MrDaila007/velopulse/STATUS.md

# Статус проекта

Обновлено: 2026-08-20

## Снимок веток

| Ветка | Состояние | Комментарий |
| --- | --- | --- |
| `dev` | **Активная разработка** | BLE Э4, Flutter MVP, ПК веб-компаньон, ambient auto-calibration |
| `main` | Устарела | Отстаёт от `dev`; актуальный код только на `dev` |
| `feat/speed-gap-reboot-load-config` | Влита в `dev` (`4dd8437`) | Исходная ветка на 3 коммита впереди своей копии в `dev` |
| `cursor/weather-carousel-5d1a` | Влита в `dev` | Weather-страницы карусели |
| `cursor/peripheral-features-research-c36d` | Не влита | Research/backlog доки по периферии, вне текущей области |
| `cursor/update-project-status-9eb0` | Не влита, устарела | Черновой docs-sync от 2026-08-08; заменён этим обновлением |

Версии продукта — [`version.toml`](version.toml): BLE protocol `1.2`, firmware
Arduino `0.2.0`, firmware Zephyr `0.2.0-zephyr`, mobile `1.1.0+6`. Публичные релизы:
`v0.2.0-beta.1/2/3`.

## Текущий этап

Э4 — BLE-интеграция. Э4.1–4.15 программно реализованы: advertising, команды,
encryption, pairing window и BLE CSC central (C3 каденс / S3 скорость, ADR-014).
Базовая интеграция Android-приложения с реальным XIAO подтверждена пользователем.
Полный hardware gate Э5 и полевая проверка Cycplus C3/S3 ещё открыты.

## Готово

### Прошивка (Arduino, PlatformIO)

- PlatformIO-проект для XIAO nRF52840 Sense и native-окружения.
- Фильтрация импульсов, fixed-point скорость, дистанция, средняя/максимальная скорость.
- Автостарт и автопауза, неблокирующий scheduler, ISR с кольцевым буфером.
- `SpeedIntervalGuard`: отбрасывает и считает аномально короткие интервалы между
  импульсами (дребезг/наводка) до расчёта скорости, не давая ложным всплескам
  попасть в `SpeedCalculator`.
- Минимальный OLED-интерфейс, проверенный на устройстве с кнопкой вместо датчика Холла.
- GUI/headless-симулятор OLED и pixel-golden тесты состояний IDLE/MOV/PAUSE.
- `PageCarousel` с настройкой порядка, маски, периода и фиксированной страницы.
  Расширена до 7 страниц: добавлены `kWeatherClock`/`kWeatherRain` (BLE Companion
  Sync), `kValidEnabledPagesMask = 0x7F`; новые страницы opt-in
  (`kDefaultEnabledPagesMask` не изменена), появляются через второй проход
  `configure()`, не занимая слоты `page_order`.
- Общий C++-форматтер пяти нижних страниц, погодных страниц и индикатора батареи.
- Общая C++-разметка: прошивка и симулятор исполняют один и тот же код отрисовки.
- Pixel-golden кадры всех страниц, IDLE/PAUSE, неизвестного и низкого заряда.
- Два compile-time OLED-профиля из общего renderer: primary SSD1306 128×64 с
  Logisoso 38 и совместимый 128×32 с неизменными пикселями; BLE/config не менялись.
- `BatteryModel`: пересчёт ADC, калибровка, EMA, SoC LUT, монотонность и гистерезис.
- `BatteryManager`: 16 ADC-выборок и min/max rejection для внешнего делителя на P0.31.
- Аппаратная документация приведена к фактической схеме NologoTech Super-nRF52840.
- Внешний делитель 1 MΩ / 1 MΩ на P0.31 распаян и проверен: 4.016–4.037 В, 84–86% при зарядке.
- Автономная работа от Li-Po без USB и сохранение индикации заряда подтверждены пользователем.
- Установившийся разброс 16 выборок: 16–25 ADC counts (примерно 19–29 мВ).
- `DisplayPower`: приглушение на половине тайм-аута, выключение и пробуждение.
- `DisplayManager`: управление контрастом и SSD1306 power-save; корректный импульс
  колеса немедленно возвращает экран в яркий режим.
- `DisplayBurnInGuard`: независимо от auto-off раз в 60 с циклически смещает общий
  renderer на один пиксель по четырём позициям; работает для 128×64 и 128×32,
  wrap-safe и не изменяет splash/test patterns.
- `AmbientLightModel`: EMA 1/8, raw normalization, уровни 5/15/35/65/100%,
  гистерезис 5%, выдержка 2 с и invalid fallback. `AmbientLightManager` раз в
  секунду коммутирует D3, на следующем tick усредняет 16 ADC-выборок с min/max
  rejection; `brightness_pct` остаётся пользовательским максимумом.
- **Ambient light auto-calibration** (влито в `dev`, коммит `7b1d52d`):
  `AmbientLightCalibrator` подстраивает raw dark/bright границы по наблюдаемым
  выборкам во время работы, с оценкой качества (`kNarrow`/`kOk`) по ширине диапазона
  и допустимым dark/bright порогам; `AmbientCalibrationSavePolicy` — независимый от
  `OdometerSavePolicy` набор триггеров: time-throttled изменения плюс
  one-shot deep sleep/reboot/USB disconnect. Хранится в новых A/B-слотах
  `/alc_a`/`/alc_b` (`StoragePaths`), record version 1, payload 5 байт. При старте
  калибровка загружается и используется как seed вместо статических
  `BIKECOMP_AMBIENT_RAW_DARK/BRIGHT`; переживает deep sleep, reboot и USB disconnect.
- Канонический little-endian codec 48-байтовой `DeviceConfig` без зависимости от
  C++ padding; валидируются все диапазоны, маска/порядок страниц и имя устройства.
- `StorageManager`: `/cfg_a/b`, `/odo_a/b`, `/alc_a/b` и `/cnt_a/b`, заголовок `BKCP`,
  version, sequence, CRC32, выбор свежего слота, чередование записей и пропуск
  неизменённых данных.
- При повреждении одного слота используется второй; при повреждении обоих defaults
  записываются в слот A (кроме `StorageCounters` — см. ниже). Одометр, общее число
  оборотов, ambient-калибровка и `StorageCounters` восстанавливаются при старте.
  Для `StorageCounters` это правило про defaults не действует: если оба
  `/cnt_a`/`/cnt_b` отсутствуют или повреждены, `loadStorageCounters()` не пишет
  ничего в Flash — `counters_` просто остаётся в нулевом RAM-состоянии до
  следующего `saveStorageCounters()` на контрольной точке.
- Serial при старте показывает mount status, source, sequence, version, recovery/
  defaults, migration и восстановленное значение одометра.
- `OdometerSavePolicy`: независимые триггеры дистанции (`odometer_save_interval_m`),
  settle 30 с после `MOVING→PAUSED`, OLED off, deep sleep, `FORCE_SAVE`, critical
  battery ≤5% (однократно), USB disconnect и reboot; ошибка Flash не останавливает
  поездку. `AppController` пишет одометр и логирует trigger/result/sequence/counters.
- **Device reboot**: команда `reboot` в Serial-консоли и BLE `CommandId::kReboot` —
  сначала пытаются сохранить одометр (`OdometerSaveTrigger::kReboot`), затем ставят
  отложенный флаг и выполняют системный reset через 250 мс
  (`AppController::loop`, `reboot_pending_`/`reboot_requested_ms_`).
- `storage_migration`: `migrateConfigV1ToV2` / `migrateOdometerV1ToV2` (identity stub
  при неизменном payload); `RecordHeader.version` = 2. При load запись v1
  мигрируется, перезаписывается как v2 (force write); будущая version отвергается.
  Счётчики `config_migrations` / `odometer_migrations`.
- `diagnostics`: snapshot §6.1 (`raw_pulse_count`, debounce/overspeed rejects,
  `isr_overflow`, `flash_write_count` ← `StorageCounters::writes`,
  `free_heap` через `dbgHeapFree()`, i2c/selftest). Little-endian 16-byte payload
  возвращается через `GET_DIAGNOSTIC`. Serial dump при старте;
  `AppController::diagnosticSnapshot()`. `StorageCounters` персистируются в
  `/cnt_a|b` на контрольных точках, не на каждой записи (см. «Ограничения»).
- **Watchdog (Э2.1-долг закрыт)**: nRF52 WDT через `src/platform/watchdog_nrf52.cpp`
  (`nrf_wdt.h` HAL напрямую — `nrfx_wdt` driver source не собран в этом core,
  `nrfx_wdt_*` не слинковался бы). `watchdogConfigure()` вызывается первой строкой
  `begin()` (CONFIG/RREN/CRV блокируются после старта), `watchdogStart()` —
  последним шагом `begin()`, после Serial-ожидания, монтирования FS, boot-counter
  и SoftDevice init. `watchdogFeed()` безусловно первой строкой `loop()` и перед
  входом в deep sleep. Таймаут 8 с (`BIKECOMP_WDT_TIMEOUT_MS`,
  `watchdog_config.h::watchdogTimeoutMsToCrv`), RUN_SLEEP behaviour (считает во
  сне, пауза под отладчиком). Выключается сборочным флагом
  `BIKECOMP_FEATURE_WATCHDOG=0`. `kSelftestWatchdogOk` выставляется при успешном
  старте. Serial-команда `wdt-hang` вешает `loop()` для проверки реального сброса.
  Попутно исправлен смежный баг: `deepSleepWakeFromSleep()` перечитывал уже
  очищенный `NRF_POWER->RESETREAS` и никогда не репортил `wake_source=hall/usb` —
  теперь кэшированное значение передаётся параметром.
- **Scheduler task timing (Э2.1)**: `ScheduledTask` хранит `last_duration_us`/
  `max_duration_us`/`overrun_count` против per-task `budget_us`, замеряется через
  инжектируемый `Scheduler::MicrosFn` (домен остаётся Arduino-независимым).
  `AppController` подключает `micros()` и именованные бюджеты с headroom под
  flash-запись (state/ambient/display/battery — один write, ble — до трёх при
  factory reset). Serial-команда `sched`. Попутно исправлен смежный баг:
  `Scheduler::nextDueMs` сравнивал сырые `next_due_ms` вместо wrap-safe дельты и
  мог занизить срочность задачи почти на 2^31 мс вокруг переполнения `millis()`.
- **Async flash writes**: `StorageBackend::beginWrite`/`pollWrite`
  (`storage_manager.h`) заменили синхронный `write()`; `InternalFsBackend`
  (`internal_fs_backend.{h,cpp}`) разбивает remove+open+write+flush+close на
  два `pollWrite()`-тика. Новая scheduler-задача `"storage"`
  (`AppController::pollStorageSave`) двигает mid-ride сохранения одометра/
  ambient-калибровки/counters; старые синхронные `saveConfig`/`saveOdometer`/
  `saveAmbientCalibration`/`saveStorageCounters` остались тонкими
  begin+drain обёртками для boot-time и non-hot-path вызовов. Deep sleep и
  оба `reboot`-чекпоинта синхронно дренируют (`drainStorageSave()`) любую
  незавершённую запись перед power-off/reset.
- BLE Э4.1–4.14: `BleManager` GATT + live Device Info на Read (uptime, flags,
  bonded, pairing window); FICR serial; `reset_reason` из `NRF_POWER->RESETREAS`;
  `boot_count` в `/boot_cnt`; live Telemetry notify (seq + adaptive 1 Гц /
  0.2 Гц Read refresh; sensor-test 5 Гц); Config Write pending queue +
  validation/apply + Config Read notify. Safe Command `0x01–0x0B`: strict parser,
  single-slot queue и выполнение в main loop (`RESET_TRIP/MAX`, `FORCE_SAVE`, OLED,
  display/sensor/battery tests, diagnostics, reboot); корректные `Command Result`
  status, `detail` и 16-byte payload; sensor-test завершается по timeout/disconnect.
  ADV Flags + Service UUID, Scan Response name + Tx Power; fast 30 мс первые 30 с,
  slow 1000 мс, постоянная реклама по умолчанию либо stop через 5 минут; рестарт
  после disconnect/движения, runtime-применение имени и policy. Имя `BikeComp-XXXX` →
  serial (`ble_identity`); ack одометра только при успехе Flash; hot-path Serial
  за `BIKECOMP_HOTPATH_SERIAL` (по умолчанию выкл).
  Dangerous Command `0x20–0x40`: двухфазный request/confirm, аппаратный 32-bit
  nonce, TTL 30 с, binding к command/payload/connection, обязательный bonded link,
  single-slot execution и token/error statuses. Реализованы reset odometer/factory,
  reboot с отложенным reset, battery calibration, set odometer и runtime pairing
  window; параметры сохраняются до ответа OK.
  Adafruit BLEDfu в том же `BleManager`: buttonless переход в bootloader OTA
  (`GPREGRET=0xB1`) при записи DFU Control Point; первая заливка при мёртвом USB —
  `firmware/scripts/flash_stlink.sh`, дальше `firmware.zip` с телефона. Это не
  Nordic Secure DFU v1.1.
- **BLE CSC central (Э4.15, ADR-014):** dual-role `Bluefruit.begin(1, 1)`. BikeComp
  остаётся peripheral для приложения и одновременно central к одному датчику
  CSC `0x1816`. CYCPLUS C3 даёт каденс (`cadence_x10`, OLED CAD); CYCPLUS S3 даёт
  скорость/одометр через синтетические обороты и `wheel_circumference_mm`. Пока
  S3 свежий (менее 4 с), импульсы Холла не считаются. Bond в `/csc_a` `/csc_b`,
  Serial `csc-pair`/`csc-forget`/`csc-status`. ANT+ не используется (S140).
  Telemetry v2 — 44 байта, протокол 1.2. Zephyr CSC central — заглушка.
  Pairing/bonding: LESC Just Works, Flash bond store Bluefruit, encrypted GATT
  permissions, release-default `BIKECOMP_OPEN_PAIRING=0`; новые pairing requests
  после 5 минут отклоняются disconnect + defensive bond revoke, сохранённые bonds
  допускаются. Dangerous commands требуют одновременно bonded и encrypted link.
  Android preflight показывает typed `notPaired` по Device Info без reconnect-loop.
  Error Log: RAM-кольцо 16 событий, Read/Notify последних 4 в хронологическом порядке;
  регистрируются I²C/Flash/config reject/pairing reject/ISR overflow/sensor stuck/
  watchdog/critical battery. Sensor-test использует нормативные Telemetry fields и
  принудительный интервал 200 мс; timeout, stop и disconnect завершают режим.
  BLE Companion Sync: время и погода на OLED (protocol 1.1, характеристика `000B`) —
  питает страницы `kWeatherClock`/`kWeatherRain`.
- Неблокирующая USB Serial-консоль: `open-pairing`, `dump-config`, `reset-odo`,
  `reboot`, `selftest`; CR/LF, ограничение длины и восстановление после переполнения
  проверены native-тестами. `dump-config` возвращает читаемые поля и точный 48-byte
  wire payload. Регрессионный протокол и host-runner: `tools/usb_regression.py`.
- **BLE-индикатор на OLED (Э2.7 закрыт)**: `DisplaySnapshot`/`DisplayFrame`
  (`include/types.h`) содержат `ble_connected`; общий `display_layout.cpp` рисует
  `"BLE"` при подключении (pixel-golden покрытие в `simulator/`); AppController
  подключает живое значение — `snapshot.ble_connected = ble_.bleConnected();`
  в `AppController::updateDisplay()` (`src/app_controller.cpp`).

### Мобильное приложение (Flutter)

- `mobile-app`: Flutter 3.44.7, application ID `app.bikecomp.mobile`, minSdk 24,
  compileSdk/targetSdk 36; четыре Material 3 раздела и connecting overlay-route.
  Реализованы protocol v1 Freezed-модели/codecs, полный ConfigValidator,
  `FakeBleTransport`, production `flutter_reactive_ble` transport, Android
  permissions/adapter/location/bond layer, FSM/reconnect, domain repository,
  write-then-verify и versioned per-device dirty drafts. Устранена lifecycle race,
  где `unawaited(stopScan())` закрывал только что созданный scan stream. Discovery
  выполняет нефильтрованный platform scan с локальной проверкой service UUID и
  fallback по имени `BikeComp-*`; после connect полный GATT-контракт обязателен.
  Device Info читается до protected GATT operations; encrypted Config Read завершает
  pairing до subscriptions. Ошибки sync и cancel освобождают единственный BLE link.
  Settings показывает «Максимальная яркость» с пояснением автоматики; Maintenance
  отправляет fill/checkerboard/text через существующую команду `DISPLAY_TEST`,
  без изменения BLE wire format.
  Dashboard, MVP settings, defaults и maintenance не включают diagnostics/export/
  dangerous commands Э6.
  Воспроизводимый Flutter/JDK/Android SDK/NDK/CMake toolchain лежит в игнорируемой
  `.tooling/` и разворачивается `tool/bootstrap-mobile.sh`.

### ПК веб-компаньон

- `web-app/` (см. [`docs/10-web-app.md`](docs/10-web-app.md)): локальное веб-приложение
  для Chrome/Edge на ПК. Повторяет BLE-функции Flutter-компаньона (Web Bluetooth) и
  добавляет USB CDC Serial-консоль для отладки (Web Serial) — не поддерживается в
  Safari/Firefox/на мобильных браузерах, требует secure context (`https://` или
  `http://localhost`).

## Проверки

- `pio test -e native`: **128/128** тестов проходят (прогнано 2026-08-10), включая
  ambient auto-calibration, автояркость, weather-страницы, Serial ambient/display
  commands, advertising, safe/dangerous framing, shared fixtures, Config Write,
  diagnostics, Serial parser, watchdog CRV, Scheduler timing/wrap и
  wake-source classification.
- `pio run -e xiao_ble_sense`: primary 128×64 собирается, RAM 17 968 Б,
  Flash 191 492 Б (прогнано 2026-08-10, после watchdog+scheduler timing;
  +96 Б RAM — 4 новых `uint32_t` на 6 задач `ScheduledTask`).
- `pio run -e xiao_ble_sense_128x32`: compatible build собирается, RAM 17 456 Б,
  Flash 191 428 Б (прогнано 2026-08-10).
- `pio run -e xiao_ble_sense_deep_sleep`: собирается, RAM 17 968 Б,
  Flash 191 876 Б (прогнано 2026-08-10).
- Сборка с `-DBIKECOMP_FEATURE_WATCHDOG=0`: собирается, WDT не стартует
  (`kSelftestWatchdogOk` не выставляется) — прогнано 2026-08-10.
- `./simulator/test.sh`: 6 групп проверок, **24 golden-кадра** (12 сценариев ×
  128×32/128×64, включая `weather_clock`/`weather_rain`) — подтверждено 2026-08-10.
- Boot smoke на XIAO (`/dev/ttyACM0`): `BLE GATT: OK`, `BLE ADV name: BikeComp-D210`
  (не литерал `XXXX`), `OLED OK`, `selftest=0x3F`, `heap/16≈12695`, устройство
  стабильно после SoftDevice init.
- Embedded A/B-тест прошёл на XIAO: mount, A/B-чередование, чтение и fallback после
  повреждения свежего слота; `/test_storage_a/b` удалены после теста.
- Embedded odometer A/B на `/test_odo_a/b`: чередование и fallback после повреждения
  свежего слота; тестовые файлы удалены после теста (`pio test -e xiao_ble_sense`).
- DoD Э3.5 reboot на `/dev/ttyACM0`: seed 424242 mm / 77 rev переживает два reboot
  production (`Odometer: source=A, sequence=3`, те же значения оба раза).
- Mobile automatic gate: `dart format`, `flutter analyze` — no issues;
  `flutter test` — 52/52; актуальный release APK собран.
- Release APK: application ID `app.bikecomp.mobile`, minSdk 24, target/compileSdk 36,
  54,049,637 байт (`a31959c20eeb972c60070b30567f6f12bf94fc12a58051a64bc3203e7944f1c2`).
- Android-устройства через ADB и Bluetooth controller на хосте нет;
  локальные результаты не являются аппаратной приёмкой BLE.
- Primary production-сборка SSD1306 128×64 загружена на XIAO. Serial smoke:
  `i2c_err=0`, `isr_ovf=0`, `selftest=0x3F`, `heap/16=12630`. Пользователь подтвердил
  крупную разметку и работу экрана. Ранее проверенный профиль 128×32 остаётся
  совместимой сборкой; `reset-odo` на пользовательских данных не выполнялся.
- Ранее: два старта подряд прочитали config/odometer из слота A с `sequence=1`,
  без роста sequence и лишней записи.
- Пользовательский лог nRF Connect от 2026-07-31 подтверждает обнаружение
  `BikeComp-D210`, connect, service discovery, bonding и чтение Device Info,
  Telemetry, Config Read, Command Result и пустого Error Log. Ошибки
  `GATT READ NOT PERMIT` относятся к попыткам чтения descriptor у write-only chars;
  Config Write, команды и bond persistence этим логом не проверялись. Лог
  заканчивается без disconnect: пока nRF Connect держит единственное peripheral
  connection, firmware штатно не рекламируется и другое приложение его не найдёт.
- Android hardware smoke от 2026-07-31: после освобождения BLE-соединения в
  nRF Connect пользователь подтвердил, что новый release APK обнаруживает устройство,
  подключается и работает. Это закрывает базовую end-to-end интеграцию, но не заменяет
  измерение поиска ≤5 с, серию 10/10 и остальные пункты аппаратного gate.
- Прошивка загружалась на XIAO; OLED и импульсы кнопки подтверждены пользователем.
- Сборка `424fbc7` с общей C++-разметкой загружена на XIAO через `/dev/ttyACM0`.
- Сборка `4335e65` с энергосбережением OLED загружена через `/dev/ttyACM0`.
- На устройстве подтверждены приглушение через 30 секунд, выключение через 60 секунд
  и немедленное пробуждение по импульсу кнопки D0.
- На реальном OLED 128×32 подтверждены постоянная скорость, батарея справа сверху и
  автоматическая смена пяти нижних значений.
- Hardware smoke SSD1306 128×64 от 2026-07-31: primary firmware загружена на XIAO;
  Serial вернул `i2c_err=0`, `isr_ovf=0`, `selftest=0x3F`, `heap/16=12630`;
  крупная разметка и работа экрана подтверждены пользователем.
- Production 128×64 с автояркостью загружена через `/dev/ttyACM1` 2026-08-01.
  Без подключённого LDR три последовательных selftest дали `raw=0`, `valid=0`,
  `auto_pct=100`, `effective_pct=40`, `i2c_err=0`, `isr_ovf=0`,
  `selftest=0x3F`: аппаратный disconnected-sensor fallback подтверждён.
- Serial gate tools 2026-08-01: `pio test -e native` (83/83 на тот момент);
  `tools/oled_gate_serial.py` на XIAO подтвердил dim (30 с), off (60 с), wake;
  `tools/ldr_calibrate.py` — LDR не обнаружен; `tools/android_gate.sh` —
  format/analyze/52 tests/release APK.

## Ограничения

- Реальный датчик Холла и повторяемый стенд импульсов ещё не проверены.
- SSD1306 128×64 подключён и прошёл базовый hardware smoke; ещё не зафиксированы
  `LOW BATT`, test patterns, полный dim/off цикл и четыре фазы burn-in pixel shift.
- LDR-делитель ещё не собран: raw dark/room/outdoor, итоговый резистор,
  плавность переходов, максимумы 10/60/100% и средний ток ≤20 мкА ждут
  аппаратной проверки. Auto-calibration подстраивает пороги в рантайме и переживает
  reboot, но не заменяет физическую сборку делителя и замер тока.
- Штатные NPR-позиции делителя не используются; внешний делитель P0.31 подтверждён.
- Автосохранение одометра: native + на XIAO подтверждены odo A/B embedded и
  ненулевой odometer после двух reboot. Остаётся ручная проверка 10× power-loss
  (чтобы не уничтожить обе копии `/odo_a|b`). Тот же долг применим к новым
  `/alc_a|b` и `/cnt_a|b` — power-loss там ещё не проверялся.
- BLE: pairing enforcement и persistence собраны, но reboot/closed-window сценарии
  ещё не приняты на телефоне; лимит 4 bonds с LRU пока не реализован. Prototype
  override `BIKECOMP_OPEN_PAIRING=1` остаётся opt-in. Error Log Read/Notify и sensor
  test 5 Гц ждут BLE hardware DoD. Стандартные DIS/BAS (`0x180A`/`0x180F`) отложены;
  приложение их не использует. `flash_write_count` и остальные `StorageCounters`
  персистируются в `/cnt_a|b` только в контрольных точках — deep sleep и reboot
  (Serial `reboot`, BLE `CommandId::kReboot`) через
  `AppController::persistStorageCounters()`, не на каждой записи; значение после
  power-loss без чистого reboot отражает последний checkpoint, а не точный момент
  потери питания. Так как `StorageCounters::writes` теперь накапливается через
  весь срок службы устройства (а не сбрасывается каждую загрузку), поле
  `flash_write_count` в `GET_DIAGNOSTIC` — насыщающийся u16 (`saturateU16` в
  `diagnostics.cpp`, туда же попадает и `selftest`-снимок на Serial) — со
  временем реально достигает потолка 65535; это осознанное и уже протестированное
  поведение, не баг. Сам `StorageCounters::writes` при этом остаётся полным u32
  без потолка и виден без ограничения на Serial в строке `Odo save: ...
  writes=...` (`AppController::persistOdometer`), а не только по BLE.
  `sd_softdevice_disable` при fail init не вызываем (ломает USB CDC); teardown =
  `Advertising.stop()`.
- Watchdog реализован программно (native-тесты на CRV/wrap-safe scheduler, три
  build-окружения зелёные), но **аппаратно не подтверждён**: `wdt-hang` ещё не
  запускался на реальном XIAO, реальный сброс через ~8 с и последующие
  `reset_reason=watchdog`/`ErrorLogCode::kWatchdogReset` не проверены на железе.
  Эмулированный System OFF (подключённый отладчик) оставляет WDT считающим —
  в этом случае `tryEnterDeepSleep` кормит его перед входом в сон, но
  многочасовая debug-сессия под отладчиком с активным WDT всё равно может
  словить спонтанный сброс; для debug-сессий стоит собирать с
  `BIKECOMP_FEATURE_WATCHDOG=0`.
- Per-task бюджеты `Scheduler` (`kSched*BudgetUs` в `app_controller.cpp`) —
  оценки с запасом под flash-запись, не измерения с реального железа; после
  первого прогона `sched` на XIAO их стоит сверить с фактическими `max_us`.
- В production loop есть блокирующие участки: low-power idle `delay()` теперь
  ограничен через `clampIdleDelayMs` максимумом `kMaxIdleDelayChunkMs` = 50 мс
  (`idle_delay.{h,cpp}`) — это защитная граница на случай, если периоды
  `kLowPowerSchedulerPeriods` (`power_manager.h`) когда-нибудь ослабят, а не
  исправление наблюдаемой блокировки: сегодня `pulses_ms = 10` в этой таблице
  и так держит `next_due - now_ms` в пределах ~10 мс, так что клэмп на 50 мс
  сейчас не имеет измеримого эффекта в рантайме; flash-записи одометра/
  ambient-калибровки/counters на mid-ride пути теперь асинхронные и
  разбиты на два `pollWrite()`-тика через scheduler-задачу `"storage"`
  (см. «Готово» выше), но несколько `delay(2)` в диагностической
  `printGpioProbe()`, доступной из Serial-консоли, ещё не убраны. Оба —
  под watchdog-таймаутом 8 с (см. выше), и `sched` даёт `max_us`/`overruns`
  на задачу для их измерения.
- Mobile hardware gate не завершён. Исправленный release APK установлен, и базовые
  discovery/connect подтверждены на реальном телефоне и XIAO. Нужны измерение поиска
  ≤5 с, 10/10 connect, bonding после reboot, write-then-verify пяти настроек, все
  MVP-команды, reconnect и permission flows на Android ≤11 и ≥12.
- `flutter_reactive_ble` 5.5.0 пока применяет legacy Kotlin Gradle Plugin;
  Flutter 3.44.7 собирает APK с предупреждением. CompileSdk библиотеки принудительно
  36; до будущего обновления Flutter нужно отслеживать Built-in Kotlin миграцию.
- Migration hook — заготовка identity v1→v2; реальное расширение payload потребует
  обновления `migrate_*` и, при изменении BLE-структуры, `protocol/`.
- Zephyr-порт (`firmware-zephyr/`) не синхронизирован с этими изменениями: weather-
  страницы, speed-gap guard/reboot, web-компаньон, ambient auto-calibration,
  BLE-индикатор на экране и CSC central (C3/S3) реализованы только в Arduino-прошивке. Async flash
  writes (`StorageBackend::beginWrite`/`pollWrite`) теперь мигрированы на обеих
  сторонах Zephyr-порта: расшаренный `test/shared/memory_storage_backend.{h,cpp}`
  и реальный прошивочный бэкенд `firmware-zephyr/app/src/platform/
  littlefs_backend.{h,cpp}` (`LittleFsBackend`, `fs_unlink`/`fs_open`/`fs_write`
  разбиты на два `pollWrite()`-тика по образцу `InternalFsBackend`) — оба были
  пропущены при исходном изменении интерфейса и найдены только по двум
  последовательным падениям CI (`scripts/test.sh`, затем `scripts/build.sh`).
  Не проверено локально сборкой — Zephyr-тулчейн недоступен в этой среде,
  оба фикса подтверждены только чтением кода и совпадением с уже
  проверенным паттерном в Arduino-бэкенде.

## Следующий шаг

Watchdog и Scheduler-тайминги (Э2.1) реализованы и прошли software gate;
**аппаратная проверка `wdt-hang` на XIAO ещё не выполнена** — это первый шаг
перед тем, как считать watchdog полностью закрытым. Оставшийся софтовый долг,
готовый к реализации без стенда: устранение самих блокирующих участков
production loop (теперь измеримых через `sched`).

Параллельно — аппаратные долги: собрать LDR-делитель, измерить raw dark/room/outdoor,
выбрать резистор и загрузить production 128×64; завершить OLED gate (`LOW BATT`, три
test patterns, dim/off/wake, четыре фазы pixel shift, импульсы) и Android gate
(поиск ≤5 с, 10/10 подключений, bond/reconnect, пять write-then-verify и
MVP-команды); 10× power-loss для Э3.5 и для новых `/alc_a|b` и `/cnt_a|b`.
