MrDaila007/velopulse/docs/02-development-plan.md

# 02. План разработки

Детальный план работ по этапам с задачами, критериями завершения (DoD) и оценками.

Оценки — в **человеко-днях** (ч.-д.) для одного разработчика полного дня. Разработка
прошивки и приложения после этапа Э4 может идти параллельно двумя людьми; в одиночку
последовательность сохраняется.

Требования-источники: ТЗ §35–§41 (этапы), §44–§45 (MVP), §42–§43 (приёмка).

---

## 0. Сводка этапов

| Этап | Название | Оценка | Зависит от | Milestone |
| --- | --- | --: | --- | --- |
| Э0 | Подготовка и каркас | 3 | — | M0: сборка проходит на устройстве |
| Э1 | Аппаратный прототип | 4 | Э0, закупка | M1: железо подтверждено |
| Э2 | Базовая прошивка | 8 | Э1 | M2: устройство считает поездку |
| Э3 | Хранение данных | 4 | Э2 | M3: данные выживают reboot |
| Э4 | BLE-протокол | 8 | Э3 | M4: nRF Connect читает/пишет всё |
| Э5 | MVP-приложение | 10 | Э4 (частично параллельно) | M5: MVP по ТЗ §44/§45 |
| Э6 | Расширенное приложение | 8 | Э5 | M6: все экраны ТЗ |
| Э7 | Оптимизация и полевые испытания | 7 | Э6 | M7: релиз v1.0 |
| — | Резерв на риски (20 %) | 10 | — | — |
| | **Итого** | **~62 ч.-д.** | | |

Критический путь: Э0 → Э1 → Э2 → Э3 → Э4 → Э5 → Э7.
Работы приложения (Э5 частично, Э6) можно начать сразу после фиксации протокола на Э4
благодаря `FakeBleTransport` (эмулятор устройства на Dart) — см.
[04-mobile-app-architecture.md §10](04-mobile-app-architecture.md#10-тестирование-приложения).

### Диаграмма зависимостей

```text
Э0 ──▶ Э1 ──▶ Э2 ──▶ Э3 ──▶ Э4 ──┬──▶ Э5 ──▶ Э6 ──▶ Э7
                                  │
       (протокол зафиксирован) ────┘
       можно параллельно: кодеки + FakeBleTransport + экраны приложения
```

---

## Э0. Подготовка и каркас — 3 ч.-д.

### Задачи

| № | Задача | Оценка |
| --: | --- | --: |
| 0.1 | Инициализация репозитория, `.gitignore`, `README`, лицензия | 0.2 |
| 0.2 | Перенос документации в `docs/` и `protocol/` (этот набор) | — |
| 0.3 | Установка PlatformIO, официальной платформы Seeed и board `seeed-xiao-afruitnrf52-nrf52840`, проверка сборки пустого скетча | 0.5 |
| 0.4 | `platformio.ini` с зафиксированными версиями библиотек (ТЗ §3.2) | 0.3 |
| 0.5 | Каркас модулей прошивки: заголовки и заглушки всех классов из архитектуры | 0.5 |
| 0.6 | Настройка `env:native` и первый host-тест (CRC32) — доказательство работоспособности схемы тестирования | 0.5 |
| 0.7 | Инициализация Flutter-проекта, зависимости, структура каталогов, тема | 0.5 |
| 0.8 | CI (GitHub Actions): `pio run`, `pio test -e native`, `flutter analyze`, `flutter test` | 0.5 |

### DoD

* Обе OLED-сборки (`xiao_ble_sense`, `xiao_ble_sense_128x32`) и `pio test -e native` проходят локально и в CI.
* `flutter analyze` без предупреждений, `flutter test` проходит.
* Прошивка загружается на устройство и выводит в Serial версию и `boot_count`.

---

## Э1. Аппаратный прототип — 4 ч.-д.

Соответствует ТЗ §35.

### Задачи

| № | Задача | Оценка |
| --: | --- | --: |
| 1.1 | Закупка/приёмка компонентов по BOM | 0.3 |
| 1.2 | Монтаж на breadboard: XIAO + OLED, скетч I²C-скана | 0.4 |
| 1.3 | Вывод тестового текста U8g2, подбор шрифтов под 128×64 и 128×32, проверка контраста | 0.6 |
| 1.4 | Подключение датчика Холла, проверка уровней и фронтов осциллографом/логическим анализатором | 0.6 |
| 1.5 | **Сверка распиновки АКБ с `variant.h`** + эмпирическая калибровка ADC (см. [05 §2.2](05-hardware-design.md#22-обязательная-проверка-распиновки)) | 0.8 |
| 1.6 | Подключение Li-Po, проверка зарядки, настройка тока 100 мА, измерение статуса CHG | 0.5 |
| 1.7 | Стенд для повторяемых импульсов: колесо на подставке или генератор импульсов | 0.5 |
| 1.8 | Заполнение `hardware/wiring.md` и фото в `hardware/images/` | 0.3 |

### DoD

Все 10 проверок из [05-hardware-design.md §7](05-hardware-design.md#7-проверки-этапа-аппаратного-прототипа-тз-35) выполнены и
зафиксированы. Известны: фактические имена пинов, коэффициент делителя, рабочий зазор
датчик–магнит, полярность магнита.

### Риски этапа

Отсутствие компонентов — закупку начать до Э0. Некорректная распиновка АКБ — задача 1.5
блокирует индикацию заряда, выполнить максимально рано.

---

## Э2. Базовая прошивка — 8 ч.-д.

Соответствует ТЗ §36. Все модули домена пишутся с host-тестами.

### Задачи

| № | Задача | Оценка | Тесты |
| --: | --- | --: | --- |
| 2.1 | `Scheduler`: кооперативные задачи, безопасное сравнение `millis()`, измерение времени задач | 0.8 | native |
| 2.2 | `WheelSensor`: ISR + lock-free ring buffer, attachInterrupt с настраиваемым фронтом | 1.0 | embedded |
| 2.3 | `PulseFilter`: debounce, лимит скорости, детектор залипания, счётчики отбраковки | 0.8 | native |
| 2.4 | `SpeedCalculator`: fixed-point расчёт, сглаживание по интервалам, тайм-аут нуля | 0.8 | native |
| 2.5 | `TripComputer`: дистанция в мм, moving_time, avg, max, сброс поездки | 1.0 | native |
| 2.6 | `RideState` FSM: автостарт, автопауза (ТЗ §5.1, §5.2) | 0.6 | native |
| 2.7 | `DisplayManager`: компоновки 128×64 и 128×32, зона скорости, иконки BLE/АКБ | 1.2 | визуально |
| 2.8 | `PageCarousel` + рендер страниц, переключение по таймеру | 0.8 | native |
| 2.9 | Частота обновления 4 Гц/1 Гц, авто-выключение и включение дисплея (ТЗ §7) | 0.6 | ручной |
| 2.10 | `BatteryManager`: измерение, EMA, таблица SoC, монотонность процента | 0.8 | native (модель) |
| 2.11 | Splash-экран при старте, обработка отказа дисплея | 0.3 | ручной |
| 2.12 | Калибровка точности: сравнение расчётной скорости с эталоном на стенде | 0.5 | измерение |

### DoD

* Устройство от батареи показывает скорость, дистанцию, avg, max, время движения.
* Автостарт по первому импульсу, автопауза через 3 с (ТЗ §42.8, §42.9).
* Каждый оборот регистрируется ровно один раз на 100 медленных и 100 быстрых оборотах
  (ТЗ §42.3, §42.4).
* Погрешность скорости ≤ 2 % относительно эталона (ТЗ §42.5).
* OLED выключается после остановки и включается при новом обороте (ТЗ §42.10, §42.11).
* Уровень заряда отображается (ТЗ §42.12).
* В основном цикле нет `delay()` длительнее 1 мс; ISR не содержит запрещённых операций
  (проверка ревью кода по ТЗ §3.4).

---

## Э3. Хранение данных — 4 ч.-д.

Соответствует ТЗ §37.

### Задачи

| № | Задача | Оценка | Тесты |
| --: | --- | --: | --- |
| 3.1 | `crc32` (домен) + host-тест на эталонных векторах | 0.3 | native |
| 3.2 | `ConfigModel` + `ConfigValidator`: defaults, clamp, проверка диапазонов (ТЗ §31) | 0.8 | native |
| 3.3 | `StorageManager`: монтирование LittleFS, формат `RecordHeader`, A/B слоты | 1.0 | embedded |
| 3.4 | Загрузка при старте: выбор слота по sequence+CRC, откат к defaults при повреждении | 0.6 | embedded |
| 3.5 | Политика записи одометра: 6 триггеров из архитектуры (ТЗ §9.2) | 0.7 | embedded |
| 3.6 | Механизм миграции версии структуры (заготовка `migrate_v1_to_v2`) | 0.3 | native |
| 3.7 | Счётчики диагностики хранения: `flash_write_count`, `flash_error_count` | 0.3 | — |

### DoD

* Одометр и настройки восстанавливаются после перезагрузки (ТЗ §42.6).
* Искусственное повреждение слота (перезапись байтов) → устройство поднимается на втором
  слоте; повреждение обоих → defaults + флаг.
* Сброс поездки не сбрасывает одометр (ТЗ §42.7).
* За 5 км поездки при интервале 500 м выполнено ровно 10 записей (проверка счётчика).
* Отключение питания во время записи (10 попыток) не приводит к потере конфигурации.

---

## Э4. BLE-протокол — 8 ч.-д.

Соответствует ТЗ §38. **Ключевой этап**: после него фиксируется контракт и приложение
можно разрабатывать параллельно.

### Задачи

| № | Задача | Оценка | Тесты |
| --: | --- | --: | --- |
| 4.1 | `ble_protocol.h`: все структуры + `static_assert` на размеры | 0.5 | компиляция |
| 4.2 | `ProtocolCodec` (домен): сериализация/десериализация всех структур | 0.8 | native |
| 4.3 | Генерация фикстур `protocol/fixtures/*.hex` + `.json` из кодека прошивки | 0.5 | native |
| 4.4 | `BleManager`: сервис, 7 характеристик, дескрипторы, права доступа | 1.0 | nRF Connect |
| 4.5 | Реклама: быстрая/медленная, ADV + Scan Response, имя устройства (ТЗ §10.3) | 0.5 | nRF Connect |
| 4.6 | Device Information: сбор данных, serial из FICR, reset_reason | 0.5 | nRF Connect |
| 4.7 | Telemetry: формирование, notify 1 Гц, seq, адаптивная частота | 0.7 | nRF Connect |
| 4.8 | Config Read/Write: очередь `PendingWrite`, валидация в основном цикле, применение | 1.2 | nRF Connect |
| 4.9 | Command: разбор, безопасные команды (0x01–0x0B) | 0.8 | nRF Connect |
| 4.10 | Двухфазное подтверждение опасных команд: nonce, TTL, привязка к соединению | 0.8 | nRF Connect |
| 4.11 | Command Result: все коды статусов, `field_id` при `ERR_RANGE` | 0.4 | nRF Connect |
| 4.12 | Pairing/bonding, окно 5 минут, требование шифрования на записи (ТЗ §17) | 0.8 | телефон |
| 4.13 | Error Log (опционально), режим теста датчика 5 Гц | 0.5 | nRF Connect |
| 4.14 | Serial-консоль: `open-pairing`, `dump-config`, `selftest` | 0.3 | ручной |

### DoD

* nRF Connect (или аналог) читает все характеристики, значения совпадают с
  `protocol/data-structures.md` побайтно.
* Запись валидной конфигурации применяется и подтверждается; невалидной — отклоняется
  с указанием поля (ТЗ §42.14, §42.15).
* Сброс поездки по BLE работает (ТЗ §42.16).
* Опасная команда без токена возвращает `NEEDS_CONFIRM`; с корректным токеном — `OK`;
  с истёкшим — `ERR_TOKEN_EXPIRED`.
* Устройство продолжает считать поездку при отключённом телефоне (ТЗ §42.17, §29).
* Bonding сохраняется после перезагрузки устройства; после закрытия окна новые
  сопряжения отклоняются.
* Фикстуры зафиксированы в репозитории; `protocol/*` соответствует коду.

### Точка синхронизации

По завершении Э4 проводится ревью: `protocol/data-structures.md` ⇄ `ble_protocol.h` ⇄
фикстуры. Дальнейшие изменения протокола — только через инкремент `minor`/`major`
и обновление обеих сторон.

---

## Э5. MVP-приложение — 10 ч.-д.

Соответствует ТЗ §39 и §45 (четыре экрана). Часть задач (5.1–5.4) не требует железа.

### Задачи

| № | Задача | Оценка | Требует устройства |
| --: | --- | --: | :---: |
| 5.1 | Доменные модели (freezed): Telemetry, DeviceConfig, DeviceInfo, CommandResult, enums | 0.8 | нет |
| 5.2 | Кодеки + golden-тесты на фикстурах `protocol/fixtures/` | 1.0 | нет |
| 5.3 | `ConfigValidator` + unit-тесты границ (ТЗ §31) | 0.5 | нет |
| 5.4 | `FakeBleTransport`: эмулятор устройства, профили поездки, инъекция ошибок | 1.0 | нет |
| 5.5 | `BleTransport` на flutter_blue_plus: scan, connect, MTU, discover, read/write/subscribe | 1.2 | да |
| 5.6 | Разрешения Android 12+/≤11, состояния «BT выключен», «нет разрешения», «нет геолокации» | 0.7 | да |
| 5.7 | `ConnectionController` + FSM подключения + `ReconnectPolicy` | 1.0 | да |
| 5.8 | Экран поиска: список, RSSI, фильтр по UUID, последнее устройство, автоподключение, «забыть» | 0.8 | да |
| 5.9 | Экран подключения/синхронизации с этапами и ошибками | 0.4 | да |
| 5.10 | Главный экран: SpeedGauge, метрики, статусы, быстрые действия | 1.0 | нет (Fake) |
| 5.11 | Экран настроек MVP: окружность + пресеты шин, яркость, тайм-ауты, период страниц | 1.0 | нет (Fake) |
| 5.12 | `ConfigDraftController`: dirty-состояние, валидация полей, write-then-verify | 0.8 | нет (Fake) |
| 5.13 | Экран обслуживания MVP: сброс поездки, OLED вкл/выкл, тест датчика, сохранить, defaults | 0.6 | да |
| 5.14 | Проверка версии протокола и состояние `incompatibleProtocol` (ТЗ §32) | 0.4 | нет (Fake) |
| 5.15 | Сообщения об ошибках по таблице (ТЗ §43.15) | 0.4 | нет |

### DoD

Обязательные настройки MVP (ТЗ §45): окружность колеса, яркость, тайм-аут остановки,
тайм-аут дисплея, период переключения страниц — читаются и записываются.
Обязательные команды MVP: сброс поездки, включение OLED, тест датчика, сохранить настройки,
восстановить значения по умолчанию — работают с подтверждением результата.
Критерии ТЗ §43.1–43.13 выполнены (кроме §43.14 при отсутствии второй версии прошивки —
проверяется на `FakeBleTransport`).

---

## Э6. Расширенное приложение — 8 ч.-д.

Соответствует ТЗ §40.

### Задачи

| № | Задача | Оценка |
| --: | --- | --: |
| 6.1 | Экран диагностики: версии, uptime, счётчики, `GET_DIAGNOSTIC`, self-test, RSSI | 1.2 |
| 6.2 | Экран теста датчика: `MagnetPassIndicator`, лог интервалов, тестовая скорость (ТЗ §24) | 1.0 |
| 6.3 | Экран настроек датчика: лимит, тайм-аут, сглаживание, фронт, инверсия, debounce | 0.8 |
| 6.4 | Экран настроек питания: сон, реклама, порог заряда, калибровка АКБ (опасная команда) | 1.0 |
| 6.5 | Экран настроек дисплея (полный): страницы, порядок, постоянная строка, формат скорости | 1.0 |
| 6.6 | Экран информации об устройстве | 0.4 |
| 6.7 | Экспорт/импорт профиля конфигурации (JSON + diff перед записью) | 1.0 |
| 6.8 | Экспорт диагностического отчёта через share-sheet | 0.5 |
| 6.9 | Безопасный сброс одометра: 3 ступени + токен (ТЗ §28) | 0.6 |
| 6.10 | Полировка UX: скелетоны, пустые состояния, тёмная тема, крупный шрифт скорости | 0.5 |

### DoD

Все 10 экранов из ТЗ §20 реализованы. Профиль конфигурации сохраняется в файл и
восстанавливается. Диагностический отчёт экспортируется. Сброс одометра требует трёх
подтверждений и токена. Черновик настроек не теряется при разрыве соединения (ТЗ §30).

---

## Э7. Оптимизация и полевые испытания — 7 ч.-д.

Соответствует ТЗ §41.

### Задачи

| № | Задача | Оценка |
| --: | --- | --: |
| 7.1 | Профилирование потребления: измерение тока во всех режимах, устранение лишних пробуждений | 1.2 |
| 7.2 | Глубокий сон: реализация за feature-флагом, проверка пробуждения от GPIO и USB | 1.0 |
| 7.3 | Стабильность BLE: 100 циклов подключение/отключение, длительное соединение 2 ч | 0.8 |
| 7.4 | Защита Flash: подтверждение числа записей, тест на 500 циклов сохранения | 0.5 |
| 7.5 | Фильтрация ложных импульсов в реальных условиях: тряска, неровности, разные зазоры | 0.8 |
| 7.6 | Полевые испытания: ≥ 3 поездки, суммарно ≥ 60 км, сверка дистанции с GPS-треком | 1.2 |
| 7.7 | Watchdog и восстановление: инъекция зависания, проверка reset_reason и сохранности данных | 0.4 |
| 7.8 | Финальная приёмка по чек-листам ТЗ §42/§43, оформление протокола | 0.6 |
| 7.9 | Релиз: сборка `firmware.uf2`/`.hex`, подписанный APK, теги версий, changelog | 0.5 |

### DoD (= определение готовности v1.0)

* Все 17 + 15 критериев приёмки подтверждены с датой и исполнителем.
* Погрешность дистанции относительно GPS ≤ 2 % на дистанции ≥ 20 км.
* Ни одного зависания и ни одной потери данных за полевые испытания.
* Средний ток в idle с выключенным OLED ≤ 1.5 мА.
* Артефакты релиза собраны и подписаны, версии зафиксированы.

---

## 1. Порядок работ при одном разработчике

Рекомендуемая последовательность недель (5 рабочих дней):

| Неделя | Содержание |
| --: | --- |
| 1 | Э0 + Э1 (закупка заранее) |
| 2–3 | Э2 |
| 4 | Э3 + начало Э4 |
| 5 | Э4 |
| 6–7 | Э5 |
| 8–9 | Э6 |
| 10 | Э7 + релиз |
| 11 | Резерв на риски |

## 2. Порядок работ при двух разработчиках

| Разработчик | Э0–Э4 | Э5–Э7 |
| --- | --- | --- |
| Firmware | Э0, Э1, Э2, Э3, Э4 | Э7 (оптимизация, полевые), поддержка Э5/Э6 |
| Mobile | Помощь в Э0; кодеки и `FakeBleTransport` сразу после 4.1–4.3 | Э5, Э6 |

Точка синхронизации — завершение задачи 4.3 (фикстуры протокола). До неё мобильный
разработчик занят каркасом, темой, разрешениями и доменными моделями.

## 3. Управление изменениями протокола

1. Любая правка структур начинается с PR в `protocol/`.
2. PR обязан содержать: обновлённую таблицу полей, инкремент `minor`/`major`, новые/изменённые
   фикстуры.
3. После мержа — синхронные PR в прошивку и приложение; сборка обеих сторон должна
   проходить golden-тесты на новых фикстурах.
4. Нарушение порядка (правка кода до документа) считается дефектом процесса.

## 4. Отслеживание прогресса

* Каждая задача плана = issue с меткой этапа (`stage:E2`) и подсистемы (`fw`/`app`/`hw`).
* Критерии приёмки ТЗ §42/§43 = отдельные issue с меткой `acceptance`, закрываются только
  по факту проверки на устройстве с приложением протокола (см.
  [06-testing-and-acceptance.md](06-testing-and-acceptance.md)).
* Milestone закрывается только когда закрыты все его DoD-пункты.

## 5. Что сознательно отложено за пределы v1.0

| Функция | Когда | Задел |
| --- | --- | --- |
| BLE DFU (обновление прошивки) | v1.1 | Nordic Secure DFU bootloader, UUID `…000A` |
| Запись треков поездок | v1.2 | UUID `…0009`, кольцевой буфер во внешней QSPI Flash |
| Датчик каденса (второй Hall) | v1.2 | Свободные GPIO, отдельный канал импульсов |
| Стандартный профиль CSC | v1.1 | Дополнительный GATT-сервис, совместимость со сторонними приложениями |
| iOS-версия | v1.1 | Flutter, изолированный платформенный слой |
| IMU (наклон, авто-подсветка) | v2.0 | LSM6DS3TR-C на плате Sense |
