MrDaila007/velopulse/simulator/bikecomp-oled.png

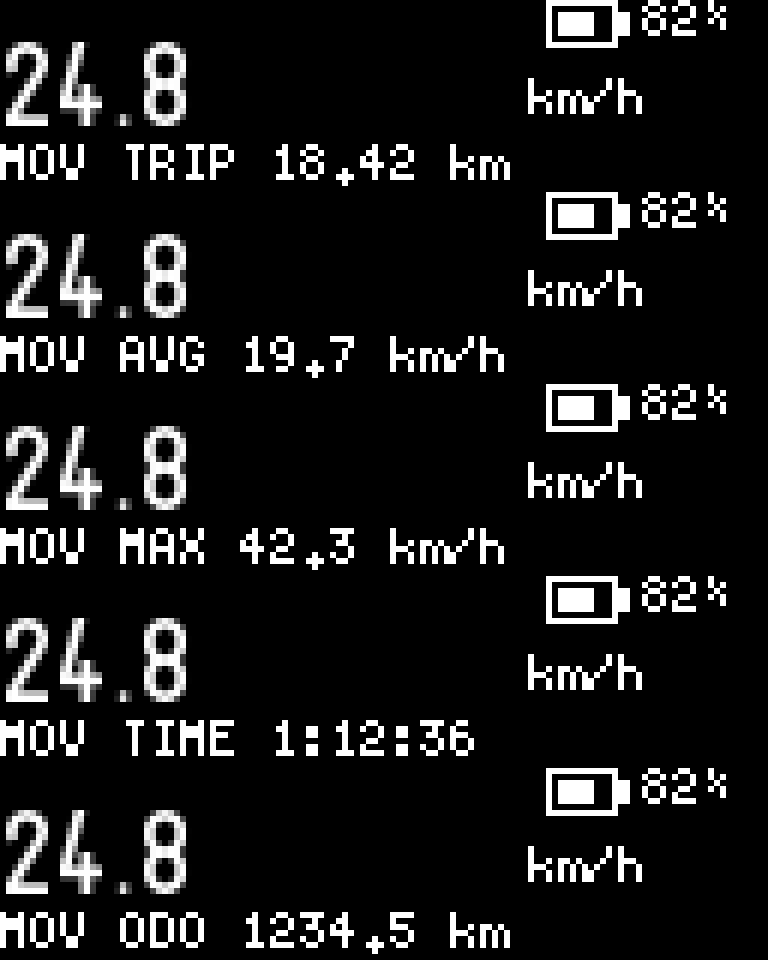
simulator/bikecomp-oled.png
