MrDaila007/velopulse/3d-models/velopulse.3mf

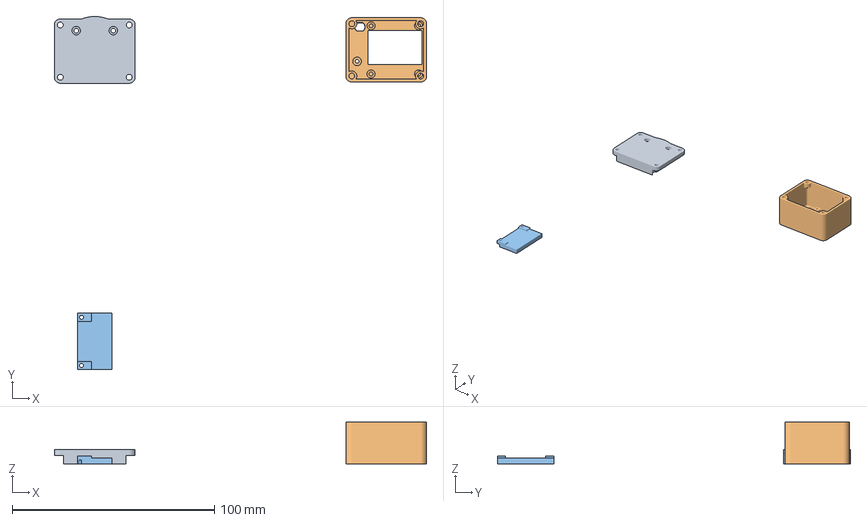
[picture p2: CAD file, 2026-08-06]
3d-models/velopulse.3mf
184.0 x 174.4 x 20.6 mm
Part24.STEP
Part23^Assem.STEP
Part28^Assem.STEP
