MrDaila007/velopulse/hardware/wiring.md

# BikeComp wiring notes

Обновлено: 2026-08-02

## LDR auto-brightness divider (task 1.10)

```text
D3/P0.29 (LIGHT_POWER) → LDR → ADC_NODE → R_FIXED (10 kΩ) → GND
                                ├── D2/A2/P0.28 (LIGHT_ADC)
                                └── 100 nF → GND
```

| Сигнал | Пин | Назначение |
| --- | --- | --- |
| LIGHT_POWER | D3 | Коммутируемое питание LDR (HIGH только при выборке) |
| LIGHT_ADC | D2 / A2 | Узел делителя, 12-bit SAADC |

### Сборка

1. **`R_FIXED` = 10 kΩ** на текущем прототипе (нижнее плечо делителя до GND). При узком
   диапазоне в ярком свете — попробовать 22 kΩ; если в темноте мало различия — 47 kΩ.
2. Установить **100 nF** между ADC_NODE и GND рядом с LDR.
3. Разместить LDR **на выносе от платы**, смотрящим наружу корпуса; экранировать от OLED.
   Прошивка с `BIKECOMP_SUPPRESS_BOARD_LEDS=1` гасит RGB и charge LED постоянно;
   синий RGB при BLE-рекламе — короткий импульс 4 мс раз в 12 с (не горит постоянно);
   при подключении телефона — выключен. `BIKECOMP_STATUS_LED_INTERVAL_MS=0` — всегда off.
4. Проверить мультиметром: при отключённом D3 ток через делитель ≈ 0.

### Калибровка

1. Прошить production firmware (`cd firmware && make upload`, либо `make flash-stlink` / `make dfu-ble`).
2. Открыть Serial 115200 и отправить `ambient-raw` (или `tools/ldr_calibrate.py`).
3. Записать `raw` в трёх условиях:
   - **dark** — LDR полностью закрыт
   - **room** — комнатное освещение
   - **bright** — яркий свет / улица
4. Цель: полезный диапазон ~100–3900; `raw_bright > raw_dark`.
5. Если диапазон узкий при 10 kΩ — попробовать 22 kΩ или 47 kΩ и повторить.
6. Обновить `firmware/platformio.ini`:

```ini
-DBIKECOMP_AMBIENT_RAW_DARK=<dark>
-DBIKECOMP_AMBIENT_RAW_BRIGHT=<bright>
```

7. Перепрошить и проверить плавность пяти уровней, caps 10/60/100% и ток ≤ 20 µA.

**Калибровка прототипа (10 kΩ, 2026-08-02):** `raw_dark=266`, `raw_bright=1126`
(наблюдаемый диапазон 305–1087 при cover/room/bright).

### Без LDR

Отключённая цепь даёт `raw=0`, `valid=0`; яркость возвращается к пользовательскому
максимуму (`brightness_pct`).

## Battery divider (verified)

```text
BAT+ → 1 MΩ → P0.31 → 1 MΩ → GND
```

## OLED (verified)

| Сигнал | Пин |
| --- | --- |
| SDA | D4 |
| SCL | D5 |
| VCC | 3V3 |
| GND | GND |

I²C address `0x3C`.

## Датчик оборотов: геркон с велокомпьютера

Снятый с покупного велокомпьютера **геркон** (reed switch) — двухпроводной, без питания.

### Прототип: D0 + D1 (текущая сборка)

Прошивка держит **D0 = LOW** как опорную «землю», **D1** читает сигнал с внутренней подтяжкой:

```text
D0 / P0.02 (OUTPUT LOW) ──┬── один контакт геркона
D1 / P0.03 (INPUT_PULLUP) ┴── второй контакт геркона
```

| Провод | Куда |
| --- | --- |
| Контакт 1 | **D0** |
| Контакт 2 | **D1** |

Питание 3V3 датчику **не нужно**.

**Логика:**
- магнит **далеко** → контакты разомкнуты → D1 = **HIGH** (подтяжка)
- магнит **у геркона** → контакты замкнуты → D1 = **LOW** (через D0)

`active_edge=0` (FALLING, **по умолчанию**) — импульс при **замыкании** (HIGH→LOW), когда магнит подносится.
`active_edge=1` (RISING) — при **размыкании** (LOW→HIGH).

Диагностика Serial: `gpio-probe`, `hall-watch`, `hall-status`.

`gpio-probe` при разомкнутом герконе должен дать **PULLUP=HIGH**; при магните у геркона — **LOW**.

### Альтернатива: D1 + GND

Если геркон подключён одним контактом к **D1**, вторым к **GND** (`BIKECOMP_HALL_TWO_WIRE=0`):

```text
D1 / P0.03 ──┬── один контакт геркона
GND ─────────┴── второй контакт геркона
```

**Аналоговый режим (`BIKECOMP_HALL_ANALOG=1`):** D1 читается как **A1**, 12-bit ADC (только при `TWO_WIRE=0`).
Serial: `hall-analog` / `hall-analog-stop`.

### Deep sleep (опционально)

При `BIKECOMP_FEATURE_DEEP_SLEEP=1` и `deep_sleep_enabled` устройство уходит в System OFF
с пробуждением по **SENSE_LOW на P0.03 (D1)** — подход магнита. Резерв: USB (VBUS).

Если геркон **уже замкнут** при уходе в сон (D1 = LOW), пробуждение произойдёт только
после отхода магнита (размыкания). Перед сном прошивка логирует предупреждение в Serial.
