MrDaila007/velopulse/docs/07-decisions-and-risks.md

# 07. Архитектурные решения (ADR) и реестр рисков

---

# Часть A. Архитектурные решения

Формат: контекст → решение → альтернативы → последствия.

## ADR-001. Целочисленная арифметика вместо float в горячем пути

**Контекст.** ТЗ §3.4 запрещает операции с плавающей точкой в ISR; ТЗ §4.4 требует хранить
дистанцию в целых миллиметрах для исключения накопления ошибки. nRF52840 имеет FPU, но
float в прерываниях требует сохранения контекста FPU и удорожает ISR.

**Решение.** Все расчёты скорости, дистанции, времени — в фиксированной точке на целых
типах. Скорость в `0.01 км/ч` (`uint16`), дистанция в мм, время в мс. Float допускается
только в форматировании вывода и в калибровке батареи (не в горячем пути).

**Альтернативы.** (1) Float везде — проще читается, но нарушает ТЗ и даёт дрейф одометра.
(2) `double` — избыточно и медленно.

**Последствия.** Формулы требуют явной проверки переполнения (сделана в
[03 §6](03-firmware-architecture.md#6-расчёт-скорости-и-дистанции)). Расчёты детерминированы
и полностью тестируются на хосте. Средняя скорость на больших дистанциях считается в
`uint64` — единственное место, где нужен 64-битный тип.

## ADR-002. Ультра-низкопотребляющий Hall switch (DRV5032) вместо A3144

**Контекст.** ТЗ §2.3 требует цифровой датчик с малым собственным потреблением.
Классический A3144 потребляет 5–8 мА непрерывно — это 120–190 мА·ч в сутки, то есть
разряд батареи 500 мА·ч за ~3 суток даже без движения.

**Решение.** TI DRV5032 (1.8–5.5 В, цифровой выход) в варианте с частотой внутреннего
опроса **2.5 кГц** — потребление порядка 5–6 мкА. Прототип допустимо собрать на A3144.

**Альтернативы.** (1) A3144 — доступнее, но убивает автономность. (2) Геркон (reed switch) —
нулевое потребление, но механический износ и дребезг. (3) Аналоговый 49E — требует ADC,
постоянного опроса и порогов; ТЗ прямо называет его временным вариантом.

**Последствия и ограничение выбора.** Самые экономичные варианты семейства (опрос 20 Гц,
0.54 мкА) **непригодны**: окно обнаружения магнита при 30–50 км/ч составляет 1.4–2.4 мс,
а период опроса при 20 Гц — 50 мс, то есть проходы магнита будут систематически
пропускаться. Поэтому выбирается вариант с опросом ≥ 1 кГц, что стоит нам единиц микроампер
вместо десятых долей — по-прежнему на три порядка лучше A3144. Расчёт окна и порядок
проверки по datasheet — в
[05-hardware-design.md §1.1](05-hardware-design.md#11-требование-к-частоте-опроса-датчика-критично).
Униполярные варианты требуют правильной полярности магнита при монтаже — отражено в
инструкции по установке.

## ADR-003. Кооперативный планировщик вместо FreeRTOS-задач

**Контекст.** Adafruit nRF52 core работает поверх FreeRTOS; `loop()` — одна из задач.
Можно создавать собственные задачи с приоритетами.

**Решение.** Единственный поток `loop()` с таблицей кооперативных задач по `millis()`.
Дополнительные FreeRTOS-задачи не создаются.

**Альтернативы.** (1) Отдельные задачи для дисплея/BLE/хранения — даёт независимость,
но добавляет синхронизацию, риски приоритетной инверсии и расход RAM на стеки.
(2) Чистый суперцикл без планировщика — код быстро превращается в набор `if (millis() - t > X)`.

**Последствия.** Нет проблем разделяемых данных (кроме ISR ↔ loop, решено ring buffer).
Требуется дисциплина: ни одна задача не должна выполняться дольше ~5 мс; рендер OLED
разбивается на фазы. Планировщик измеряет время задач — превышения видны в диагностике.

## ADR-004. Бинарный протокол сразу, без JSON-прототипа

**Контекст.** ТЗ §33 рекомендует бинарный формат, но допускает JSON для прототипа
с обязательным переходом до релиза.

**Решение.** Бинарный формат с первой строки кода. JSON не используется в BLE вообще
(остаётся только в экспорте профилей конфигурации в файл, где важна читаемость).

**Альтернативы.** JSON-прототип — быстрее стартовать, но требует двойной работы: написать,
затем переписать кодеки, тесты и приложение. Экономия на старте оборачивается потерей.

**Последствия.** Нужны фикстуры и golden-тесты с самого начала (это плюс). Отладка
«глазами» через nRF Connect сложнее — компенсируется таблицами смещений в
`protocol/data-structures.md` и Serial-командой `dump-config`.

## ADR-005. Разделение Config Read и Config Write на две характеристики

**Контекст.** ТЗ §12 перечисляет «чтение конфигурации» и «запись конфигурации» как
отдельные пункты, а §15 описывает одну характеристику с Read/Write.

**Решение.** Две характеристики: `Config Read` (Read + Notify) и `Config Write`
(Write with Response).

**Альтернативы.** Одна характеристика R/W — на один UUID меньше, но: невозможно задать
разные требования безопасности для чтения и записи; возникает гонка между обновлением
значения устройством и записью клиентом; журналирование записей неоднозначно.

**Последствия.** Приложение всегда читает актуальную конфигурацию из `Config Read`,
включая уведомление об изменениях (например, после `FACTORY_RESET`). Небольшое усложнение
клиента компенсируется однозначностью транзакции «записал → получил результат → получил
новое состояние».

## ADR-006. Поездка не персистится между перезагрузками (по умолчанию)

**Контекст.** ТЗ §42.6 требует сохранности «дистанции» после перезагрузки, §9.1 перечисляет
для сохранения одометр, но не счётчики поездки.

**Решение.** По умолчанию сохраняется только одометр и настройки. Поездка живёт в RAM.
Опциональный feature-флаг `FEATURE_TRIP_PERSIST` (по умолчанию 0) сохраняет trip вместе
с одометром в той же записи.

**Альтернативы.** Всегда сохранять trip — удваивает объём данных при каждой записи и
поднимает вопрос «когда поездка считается новой»: после перезагрузки пользователь обычно
ожидает продолжение той же поездки, но при длительном простое — новую.

**Последствия.** После перезагрузки (например, по watchdog) трип начинается заново, но
одометр цел — критерий §42.6 выполняется. Если по результатам полевых испытаний окажется,
что перезагрузки происходят (не должны), флаг включается без изменения архитектуры.

## ADR-007. Одна структура конфигурации целиком, без частичных записей

**Контекст.** Можно было бы сделать протокол «ключ-значение» и писать по одному параметру.

**Решение.** Конфигурация — одна структура фиксированного размера 48 байт, записывается
целиком, валидируется транзакционно (всё или ничего).

**Альтернативы.** TLV/ключ-значение — гибче при расширении, но: больше кода на обеих
сторонах, возможны частично применённые наборы настроек, сложнее гарантировать
консистентность (например, `pinned_page` вне включённой маски).

**Последствия.** Расширение конфигурации требует инкремента `struct_version` и правил
совместимости (описаны в `data-structures.md §1`). Клиент обязан читать актуальную
конфигурацию перед записью, чтобы не затереть чужие изменения — это явно указано в
контракте.

## ADR-008. Двухслотовое (A/B) хранение вместо журнала

**Контекст.** ТЗ §9.3 требует атомарного сохранения, контрольной суммы, версии формата и
восстановления defaults при повреждении.

**Решение.** Для каждого набора данных — два файла-слота с заголовком (magic, версия,
длина, монотонный `sequence`, CRC32). Пишем в слот с меньшим `sequence`.

**Альтернативы.** (1) Один файл + временный + rename — LittleFS поддерживает, но
атомарность rename зависит от реализации и версии. (2) Журнал (append-only) — сложнее,
требует упаковки и роста файла. (3) NVS-подобная библиотека — лишняя зависимость.

**Последствия.** Простая, доказуемая схема: в любой момент существует как минимум одна
валидная копия. Стоимость — двойной объём (незначителен) и небольшой код выбора слота.

## ADR-009. Глубокий сон — за feature-флагом, выключен в v1.0

**Контекст.** ТЗ §10.2 допускает не реализовывать глубокий сон в первой версии, если
Arduino core не обеспечивает стабильное пробуждение от GPIO, но требует архитектурного
задела.

**Решение.** Интерфейс `PowerManager::enterDeepSleep()` реализован, компилируется за
`FEATURE_DEEP_SLEEP` (по умолчанию 0). Вместо сна используется «низкочастотный idle»:
цикл 10 Гц, OLED выключен, медленная реклама, ток 0.6–1.5 мА.

**Альтернативы.** Включить сон сразу — риск «устройство не просыпается от колеса», что
критично для велокомпьютера без кнопок: пользователь не сможет включить его вообще.

**Последствия.** При длительном простое (недели) батарея разряжается. Приемлемо для v1.0.
Включение флага планируется на этапе Э7 после подтверждения стабильности пробуждения
(задача 7.2). Пробуждение проверяется 50 циклами, прежде чем флаг станет значением
по умолчанию.

## ADR-010. Окно сопряжения 5 минут после включения

**Контекст.** ТЗ §17: физических кнопок нет, поэтому нужен способ ограничить, кто может
сопрячься с устройством. Рекомендация ТЗ — 5 минут после включения.

**Решение.** Реализуем рекомендованный режим: 5 минут окно, далее только bonded-устройства.
Повторное открытие: USB-команда `open-pairing`, BLE-команда с bonded-телефона,
`FACTORY_RESET`. Для прототипа — `FEATURE_OPEN_PAIRING=1`.

**Альтернативы.** (1) Постоянно открытое сопряжение — незащищённо: посторонний может
сбросить одометр. (2) PIN-код — нет ввода на устройстве. (3) Подтверждение через USB
всегда — неудобно в поле.

**Последствия.** Пользователь должен знать: чтобы подключить новый телефон, нужно
перезапустить устройство (снять/поставить АКБ или подключить USB) и подключиться в течение
5 минут. Это отражено в тексте ошибки `notPaired` в приложении и в README пользователя.

## ADR-011. Flutter вместо Kotlin + Compose

**Контекст.** ТЗ §19 указывает Flutter как предпочтительный вариант, Kotlin + Compose —
как альтернативу для Android-only.

**Решение.** Flutter.

**Альтернативы.** Kotlin + Compose даёт прямой доступ к Android BLE API (больше контроля
над MTU, приоритетом соединения, PHY) и меньший размер APK. Но закрывает путь на iOS,
который заявлен как вероятный (ТЗ §19).

**Последствия.** BLE реализован через BSD-3 `flutter_reactive_ble` 5.5.0 и полностью
изолирован обёрткой `BleTransport`. `flutter_blue_plus` 2.x не используется из-за
коммерческой лицензии и build-time telemetry. Тонкая настройка параметров соединения
ограничена возможностями плагина; риск остаётся до аппаратного gate (см. R-08).

## ADR-012. Домен прошивки в `lib/domain` без Arduino

**Контекст.** ТЗ §3.3 предлагает плоскую структуру `src/`. Тестирование логики на железе
медленно и не покрывает краевые случаи (переполнение `millis()`, границы диапазонов).

**Решение.** Вся вычислительная логика (фильтры, расчёты, FSM, валидатор, кодеки, карусель,
модель батареи) выносится в `lib/domain/` и компилируется под `native` для host-тестов.
`src/` содержит только адаптеры к железу и оркестрацию.

**Альтернативы.** Плоская структура по ТЗ — ближе к букве ТЗ, но делает host-тесты
невозможными без mock-слоя Arduino.

**Последствия.** Структура шире рекомендованной в ТЗ §3.3, но включает все указанные
модули (соответствие обозначено в
[03 §2](03-firmware-architecture.md#2-файловая-структура)). Выигрыш — быстрые тесты
и возможность разрабатывать логику без железа.

## ADR-013. Не использовать стандартный профиль CSC в v1.0

**Контекст.** Bluetooth SIG определяет Cycling Speed and Cadence Service (`0x1816`),
который понимают сторонние приложения (Strava, Zwift и др.).

**Решение.** В v1.0 публикуется только собственный сервис (плюс Battery Service `0x180F`
как бесплатный бонус). CSC рассматривается для v1.1.

**Альтернативы.** Реализовать CSC сразу — даёт совместимость со сторонними приложениями,
но не покрывает конфигурацию и диагностику (это не входит в CSC), то есть собственный
сервис всё равно нужен, а объём работы растёт.

**Последствия.** Устройство не видно велоприложениям как датчик скорости. Добавление CSC
как **peripheral** (Strava/Zwift) остаётся отдельной задачей. Подключение BikeComp как
**central/client** к датчику CYCPLUS C3/S3 описано в ADR-014 и не отменяет это решение:
BikeComp по-прежнему не публикует `0x1816`.

## ADR-014. BLE CSC central для CYCPLUS C3/S3, без ANT+

**Контекст.** Беспроводной датчик Cycplus C3/S3 без магнита: физический переключатель
выбирает роль. **C** — каденс (реклама `CYCPLUS C3`, CSC crank revolutions).
**S** — скорость (`CYCPLUS S3`, CSC wheel revolutions). Одновременно оба режима
невозможны. Датчик говорит BLE и ANT+; BikeComp уже занимает SoftDevice S140 как
BLE peripheral для приложения.

**Решение.** Dual-role BLE: `Bluefruit.begin(1, 1)` — одно соединение peripheral
(компаньон) и одно central (CSC GATT client `0x1816` / Measurement `0x2A5B`).
Подходит любой CSC; имена `CYCPLUS*` имеют приоритет при pairing. Bond адреса
хранится в `/csc_a` `/csc_b`.

C3: каденс в `cadence_x10`, OLED-страница `kCadence` автоматически добавляется
в карусель, Hall остаётся источником скорости.

S3: дельты wheel revolutions превращаются в средние интервалы импульсов и
проходят через существующий `applyAcceptedPulse` (поездка, одометр, скорость)
с `wheel_circumference_mm` BikeComp. Пока события колеса свежие (менее 4 с),
импульсы Холла дренируются, чтобы не удвоить дистанцию. После обрыва BLE или
тишины датчика Hall снова считает. При реконнекте счётчик CSC заново
синхронизируется, чтобы не впрыснуть обороты за время разрыва.

ANT+ не реализуется: потребовал бы SoftDevice S332/S340 и отказа от текущего
Arduino nRF52 stack.

**Альтернативы.** (1) Только ANT+ — мультиподключение датчиков, но ломает текущий
BLE peripheral и toolchain. (2) CSC peripheral на BikeComp — не читает C3/S3,
нужен для Strava. (3) Второй Hall каденса — другой форм-фактор, не этот датчик.

**Последствия.** Протокол 1.2, Telemetry v2 (44 байта). Serial: `csc-pair`,
`csc-forget`, `csc-status`. Zephyr-порт CSC central не входит в этот инкремент
(команды отвечают «Arduino-only»). Нужна корректная окружность колеса для S3.
Dual-role увеличивает потребление во время сканирования CSC.

---

# Часть B. Реестр рисков

Оценка: вероятность (В) и влияние (Вл) по шкале Н/С/В. Приоритет = комбинация.

## B.1. Аппаратные и физические риски

| ID | Риск | В | Вл | Меры снижения | Триггер срабатывания |
| --- | --- | :-: | :-: | --- | --- |
| R-01 | Ложные срабатывания датчика от вибрации → завышенная дистанция | С | В | Цифровой Hall switch с гистерезисом, debounce, лимит скорости, детектор залипания; проверка §5.3 методик | Рост `revolutions` без вращения колеса |
| R-02 | Пропуск импульсов на высокой скорости | Н | В | ISR + ring buffer, отсутствие блокировок, разбиение рендера; тест 1000 импульсов | `isr_overflow > 0` или заниженная дистанция на стенде |
| R-03 | Некорректная распиновка батареи в board-пакете → неверный заряд | С | С | Обязательная сверка `variant.h` + эмпирическая калибровка (задача 1.5) | Показания ADC вне 3.0–4.3 В |
| R-04 | Смещение магнита/датчика в поездке | С | С | Держатель с двойной фиксацией, контроль после первых 50 км, диагностика `SENSOR_NO_SIGNAL` | Пропадание импульсов в поездке |
| R-05 | Влага в корпусе | С | В | IP54, заглушка USB, конформное покрытие платы датчика, испытание в дождь | Отказ после поездки в дождь |
| R-06 | Недостаточная автономность | С | С | Низкопотребляющий датчик, автовыключение OLED, медленная реклама, deep sleep как задел | Ток idle > 2 мА |
| R-07 | Дефект/недоступность компонента (XIAO, OLED) | Н | С | Закупка с запасом (по 2 шт. критичных), совместимость OLED по I²C-адресу и контроллеру | — |

## B.2. Программные риски

| ID | Риск | В | Вл | Меры снижения | Триггер |
| --- | --- | :-: | :-: | --- | --- |
| R-08 | Проблемы `flutter_reactive_ble` 5.5.0 на отдельных устройствах/версиях Android | С | В | Версия зафиксирована; плагин изолирован за `BleTransport`; compileSdk библиотеки принудительно 36; fake покрывает MTU/service/disconnect, затем gate на Android ≤11 и ≥12; отслеживать миграцию плагина на Built-in Kotlin | Сбои подключения на конкретной модели или build warning KGP |
| R-09 | MTU < 51 на старых телефонах | Н | С | Режим «только чтение» + явное сообщение; структуры спроектированы ≤ 48 байт | Согласованный MTU < 51 |
| R-10 | Нестабильность BLE-стека при длительном соединении | С | С | Watchdog, тест 2 ч, авто-переподключение в приложении, счётчик разрывов в диагностике | Разрывы чаще 1 раза в 10 мин |
| R-11 | Износ Flash при частой записи одометра | Н | В | Интервал 500 м (настраиваемый), A/B слоты, пропуск неизменившихся данных, LittleFS wear leveling | `flash_error_count > 0` |
| R-12 | Расхождение реализации протокола между прошивкой и приложением | С | В | Единый контракт в `protocol/`, фикстуры, golden-тесты на обеих сторонах, порядок изменений (план §3) | Golden-тест падает |
| R-13 | Deep sleep: устройство не просыпается от колеса | С | В | Флаг выключен по умолчанию (ADR-009), 50 циклов проверки перед включением, пробуждение по USB как резерв | Отсутствие пробуждения хотя бы в 1 из 50 циклов |
| R-14 | Переполнение `millis()`/`micros()` через 49.7 дней / 71.6 мин | С | С | Все сравнения только через разность со знаком; отдельные host-тесты на переполнение | Аномалии после длительной работы |
| R-15 | Потеря введённых настроек при разрыве соединения | С | С | Черновик в памяти + персист в `shared_preferences`, диалог применения после переподключения (ТЗ §30) | Жалоба/тест |
| R-16 | Разрешения Android блокируют сканирование | В | С | Экран-объяснение, обработка «отклонено навсегда», проверка службы геолокации на Android ≤ 11 | Пустой список при сканировании |

## B.3. Процессные риски

| ID | Риск | В | Вл | Меры снижения |
| --- | --- | :-: | :-: | --- |
| R-17 | Расползание объёма (GNSS, каденс, треки «раз уж делаем») | В | В | Явные границы v1.0 в [01 §2](01-project-overview.md#2-границы-первой-версии-v10), список отложенного в плане §5 |
| R-18 | Приложение простаивает в ожидании прошивки | С | С | `FakeBleTransport` + фикстуры сразу после задачи 4.3; параллельная работа |
| R-19 | Недооценка полевой отладки | С | С | Резерв 20 % в плане; отдельный этап Э7 на 7 ч.-д. |
| R-20 | Документация расходится с кодом | С | С | Правило «сначала `protocol/`, потом код»; golden-тесты как автоматический контроль; ревью на точке синхронизации Э4 |

## B.4. Матрица приоритетов

```text
Влияние
   В  │ R-05          R-01 R-02 R-08     R-17
      │ R-11 R-13     R-12
   С  │ R-07 R-09     R-03 R-04 R-06     R-16
      │               R-10 R-14 R-15
      │               R-18 R-19 R-20
   Н  │
      └──────────────────────────────────────────
            Н              С              В      Вероятность
```

Первоочередные (правый верхний угол): **R-17** (границы объёма), **R-01** (ложные импульсы),
**R-08** (BLE-плагин), **R-12** (расхождение протокола). Все четыре имеют конкретные меры,
встроенные в план работ, а не «повышенное внимание».
