MrDaila007/velopulse/firmware/include/types.h

#pragma once

#include <stdint.h>

namespace bike {

enum class RideState : uint8_t {
  kIdle = 0,
  kMoving = 1,
  kPaused = 2,
};

enum class ChargeStatus : uint8_t {
  kUnknown = 0,
  kNotCharging = 1,
  kCharging = 2,
};

enum class DisplayPage : uint8_t {
  kTrip = 0,
  kAverage = 1,
  kMaximum = 2,
  kMovingTime = 3,
  kOdometer = 4,
  kWeatherClock = 5,
  kWeatherRain = 6,
  kCadence = 7,
};

struct TripSnapshot {
  uint16_t speed_x100 = 0;
  uint16_t average_speed_x100 = 0;
  uint16_t max_speed_x100 = 0;
  uint32_t trip_distance_mm = 0;
  uint64_t odometer_mm = 0;
  uint32_t moving_time_ms = 0;
  uint32_t revolutions = 0;
  RideState ride_state = RideState::kIdle;
};

struct BatterySnapshot {
  bool valid = false;
  uint8_t percent = 0;
  uint16_t millivolts = 0;
  bool usb_present = false;
  bool low_battery = false;
  ChargeStatus charge_status = ChargeStatus::kUnknown;
};

struct DisplaySnapshot {
  TripSnapshot trip;
  BatterySnapshot battery;
  char companion_header[20] = {};
  bool companion_header_valid = false;
  bool companion_header_stale = false;
  char companion_weather_temp[10] = {};
  char companion_weather_rain[8] = {};
  bool companion_weather_valid = false;
  bool companion_weather_stale = false;
  bool ble_connected = false;
  uint16_t cadence_x10 = 0;
  bool cadence_valid = false;
  bool csc_connected = false;
};

struct DisplayFrame {
  char speed[16] = {};
  char units[8] = {};
  char header[20] = {};
  char weather_temp[10] = {};
  char weather_rain[8] = {};
  char lower[32] = {};
  char battery_voltage[8] = {};
  char battery_percent[5] = {};
  uint8_t battery_fill_width = 0;
  bool low_battery_warning = false;
  bool ble_connected = false;
  bool csc_connected = false;
  bool cadence_visible = false;
  char cadence[8] = {};
};

}  // namespace bike
