MrDaila007/velopulse/firmware/src/platform/deep_sleep_nrf52.cpp

#include "platform/deep_sleep.h"

#include <Arduino.h>
#include <nrf_gpio.h>
#include <nrf_soc.h>

#include "ble_device_info.h"
#include "board_pins.h"

namespace bike {
namespace {

char g_wake_source[8] = "reset";

void setWakeSource(const char* value) {
  for (size_t i = 0; i < sizeof(g_wake_source); ++i) {
    g_wake_source[i] = value[i];
    if (value[i] == '\0') break;
  }
}

}  // namespace

bool deepSleepWakeFromSleep(uint32_t resetreas) {
  switch (classifyDeepSleepWakeSource(resetreas)) {
    case DeepSleepWakeSource::kHall:
      setWakeSource("hall");
      return true;
    case DeepSleepWakeSource::kUsb:
      setWakeSource("usb");
      return true;
    case DeepSleepWakeSource::kNone:
      return false;
  }
  return false;
}

bool deepSleepPrepareAndEnter(uint32_t hall_nrf_gpio, bool sense_low) {
#if BIKECOMP_HALL_TWO_WIRE
  pinMode(kHallDrivePin, INPUT);
  nrf_gpio_cfg_input(kHallDriveNrfGpio, NRF_GPIO_PIN_NOPULL);
#endif

  pinMode(kHallSensePin, INPUT_PULLUP);
  const auto sense = sense_low ? NRF_GPIO_PIN_SENSE_LOW
                               : NRF_GPIO_PIN_SENSE_HIGH;
  nrf_gpio_cfg_sense_input(hall_nrf_gpio, NRF_GPIO_PIN_PULLUP, sense);

  // USB VBUS wake is handled by the SoC; CHG line is an additional reserve path.
  nrf_gpio_cfg_sense_input(kBoardChargeNrfGpio, NRF_GPIO_PIN_NOPULL,
                           NRF_GPIO_PIN_SENSE_LOW);

  sd_power_system_off();
  return false;
}

const char* deepSleepWakeSourceName() { return g_wake_source; }

}  // namespace bike
