MrDaila007/velopulse/firmware-zephyr/app/src/services/battery_manager.cpp

#include "battery_manager.h"

#include "adc_io.h"
#include "platform.h"

namespace bike {
namespace {

constexpr uint32_t kSamplePeriodMs = 1000;
constexpr uint32_t kPercentPeriodMs = 10000;
constexpr uint8_t kSampleCount = 16;
constexpr uint16_t kDisplayLoadCompensationMv = 25;

}  // namespace

void BatteryManager::begin(const DeviceConfig& config, uint32_t now_ms) {
  config_ = &config;
  sample();
  model_.recalculate(usbPresent(), config.low_battery_pct);
  last_sample_ms_ = now_ms;
  last_percent_ms_ = now_ms;
}

void BatteryManager::applyRuntimeConfig(const DeviceConfig& config,
                                        uint32_t now_ms) {
  config_ = &config;
  model_.recalculate(usbPresent(), config.low_battery_pct);
  last_percent_ms_ = now_ms;
  (void)now_ms;
}

bool BatteryManager::update(uint32_t now_ms) {
  if (config_ == nullptr) return false;
  if (static_cast<uint32_t>(now_ms - last_sample_ms_) >= kSamplePeriodMs) {
    sample();
    last_sample_ms_ = now_ms;
  }
  if (static_cast<uint32_t>(now_ms - last_percent_ms_) < kPercentPeriodMs) {
    return false;
  }
  model_.recalculate(usbPresent(), config_->low_battery_pct);
  last_percent_ms_ = now_ms;
  return true;
}

bool BatteryManager::runTest(uint32_t now_ms) {
  if (config_ == nullptr || !sample()) return false;
  model_.recalculate(usbPresent(), config_->low_battery_pct);
  last_sample_ms_ = now_ms;
  last_percent_ms_ = now_ms;
  return model_.snapshot().valid;
}

bool BatteryManager::sample() {
  if (config_ == nullptr) return false;

  uint16_t minimum = 4095;
  uint16_t maximum = 0;
  uint32_t sum = 0;
  for (uint8_t i = 0; i < kSampleCount; ++i) {
    uint16_t raw = 0;
    if (!adc_io::readChannel(adc_io::AdcChannel::kBattery, raw)) return false;
    if (raw < minimum) minimum = raw;
    if (raw > maximum) maximum = raw;
    sum += raw;
  }

  last_raw_spread_ = maximum - minimum;
  last_raw_average_ =
      static_cast<uint16_t>((sum - minimum - maximum + 7u) / 14u);
  uint16_t millivolts = BatteryModel::rawToMillivolts(
      last_raw_average_, config_->batt_cal_scale_permille,
      config_->batt_cal_offset_mv);
  if (millivolts <= 65535u - kDisplayLoadCompensationMv) {
    millivolts += kDisplayLoadCompensationMv;
  }
  return model_.addVoltageSample(millivolts);
}

bool BatteryManager::usbPresent() const { return platform::usbPresent(); }

}  // namespace bike
