MrDaila007/velopulse/(commit log)

2026-07-28 docs: align display pages with persistent battery indicator
2026-07-28 feat: add battery state model
2026-07-28 feat: read Super-nRF52840 battery ADC
2026-07-28 feat: show low battery OLED warning
2026-07-28 docs: document Super-nRF52840 battery circuit
2026-07-28 fix: use external battery divider on P0.31
    [battery_manager.cpp, board_pins.h]
2026-07-28 fix: support 1M battery divider
    [battery_manager.cpp, board_pins.h, test_main.cpp]
2026-07-28 docs: record external battery divider test
2026-07-28 docs: confirm battery-powered operation
2026-07-28 feat: add OLED power state policy
2026-07-29 feat: dim and power off inactive OLED
2026-07-29 docs: record OLED power firmware upload
2026-07-29 docs: confirm OLED power saving on hardware
2026-07-29 feat: define canonical device config format
2026-07-29 feat: add economical odometer autosave policy
    Persist odometer on distance, pause settle, OLED off, power, and API
    triggers without blocking the ride when Flash writes fail.
    [app_controller.cpp, app_controller.h, display_manager.cpp, display_manager.h, test_main.cpp]
2026-07-29 feat: add BLE protocol structs, codecs and fixtures
    [ble_protocol.h, test_main.cpp]
2026-07-29 docs: record Э3.5 hardware DoD progress
2026-07-30 feat: add BLE GATT manager with advertising and QA fixes
    Wire BleManager GATT/ADV into AppController, resolve BikeComp-XXXX from FICR serial, harden odometer oneshot ack and free_heap diagnostics, and cover with native + smoke waits.
    [app_controller.cpp, app_controller.h, ble_manager.cpp, ble_manager.h, test_main.cpp, test_smoke.cpp]
2026-07-30 feat: add live BLE Device Info uptime boot count and reset reason
    [app_controller.cpp, ble_manager.cpp, ble_manager.h, test_main.cpp]
2026-07-30 feat: add BLE error event log
    [app_controller.cpp, app_controller.h, ble_manager.cpp, ble_manager.h, test_main.cpp]
2026-07-31 feat: protect OLED from static-image burn-in
    [display_manager.cpp, display_manager.h, test_main.cpp]
2026-07-31 docs: add ambient light sensor design
2026-07-31 fix: detect disconnected ambient light sensor
    [ambient_light_manager.cpp, ambient_light_manager.h, app_controller.cpp, app_controller.h]
2026-07-31 docs: record disconnected ambient sensor smoke
2026-07-31 feat: add Serial gate tools for LDR calibration and OLED checks
    Expose ambient-raw/stop and display-state/wake-display commands, add
    hardware wiring notes and host scripts for LDR sampling and automated
    dim/off/wake verification on XIAO.
2026-08-02 feat: add two-wire reed hall input and board LED control
    Support D0+D1 reed wiring with digital polling, Serial hall/gpio diagnostics,
    prototype LDR calibration, and low-power board LEDs (charge/RGB off, rare BLE blink).
2026-08-02 feat: add Zephyr RTOS migration scaffold to current firmware status
    - Add firmware-zephyr west workspace (Zephyr 4.1, xiao_ble/nrf52840)
    - Link shared domain layer and port AppController with platform shims
    - Implement GPIO wheel sensor, LittleFS storage, headless display/BLE stubs
    - Document migration plan in docs/08-zephyr-migration.md and tasks/firmware/zephyr.md
    - Verified west build produces zephyr.uf2 (RAM 23%, Flash within UF2 layout)
2026-08-02 feat: add speed gap guard and mobile ride log export
    Sanitize pulse intervals before speed smoothing to reduce spikes from missed
    hall events while keeping revolution counting unchanged. Add BLE diagnostic
    decoding, session telemetry buffering, and JSON log export with share in the app.
    [test_main.cpp]
2026-08-02 feat: complete Zephyr Z1/Z2 and add serial upload tooling
    Port Super-nRF52840 peripherals, u8g2 OLED display, and PIO-style
    adafruit-nrfutil upload so boards can be flashed over USB without UF2 drag-and-drop.
2026-08-02 test: add Zephyr ztest domain suite and wire CI/CD
    Run 17 host unittest cases via Twister in CI and release workflows,
    with shared protocol fixture helpers and make test for local runs.
2026-08-02 feat: show battery voltage on OLED status bar
    Display percent and millivolt readout on the left with the charge icon on
    the right, and update simulator goldens for the new layout.
2026-08-02 feat: complete Zephyr Z3 BLE port and Z4 acceptance gates
    Add Zephyr BT GATT manager, mobile firmware backup/restore, ztest command
    fixtures, west build CI, and twister CI fix for shallow Zephyr clones.
    [ble_manager.h, ble_manager_stub.cpp, ble_manager_zephyr.cpp]
2026-08-02 feat: add PowerManager FSM with scheduler periods and BLE flags
    Introduce domain-layer power state machine, dynamic task periods, and
    telemetry bits for config, deep-sleep pending, and short-stop states.
2026-08-02 feat: add nRF52 deep sleep adapter and build profile
    Wire compile-time deep-sleep support, hall/USB wake hooks, and BLE
    advertising control needed before entering System OFF.
2026-08-02 feat: add USB serial regression protocol and host runner
    Add test-on/test-off line protocol, fixture runner under tools/, and
    trip helpers that keep odometer totals isolated from injected pulses.
    [test_usb_regression.py, usb_regression.py]
2026-08-02 feat: integrate power saving, USB tests, and status command
    Wire PowerManager into the runtime loop, protect odometer persistence
    during USB regression sessions, and add a status serial snapshot.
2026-08-02 feat(mobile): add power save and deep sleep settings UI
    Expose firmware power-save toggles and deep-sleep timeout controls in
    settings with Russian localization.
2026-08-03 feat: add BLE companion sync for clock and weather on OLED
    Phone pushes soft RTC and Open-Meteo weather via Companion Write (BLE 1.1);
    the display shows time, temperature, and rain chance in the right column.
    Also fixes BLE discoverability under power save, scan reconnect UX, and app 1.1.0 settings.
    [app_controller.cpp, app_controller.h, ble_manager.cpp, ble_manager.h, ble_protocol.h, test_main.cpp, types.h]
2026-08-03 feat: add unified versioning and fix display-off with BLE connected
    Centralize Arduino, Zephyr, and mobile versions in version.toml with sync_versions.py
    and CI verification; show firmware stack and BLE protocol in app settings. Fix DISPLAY_OFF
    being overridden while the phone stays connected; harden companion settings and scan reconnect.
    [app_controller.cpp, ble_protocol.h, sync_versions.py, test_main.cpp]
2026-08-04 docs: document mobile app current implementation state
    Captures what mobile-app actually implements on dev (vs. the
    original 04-mobile-app-architecture.md plan), including features
    added since the plan (companion sync, firmware migration backup,
    log export) and gaps (generic dangerous-command flow, profile
    export/import). Adds a known-issues section from a code review of
    the BLE transport, protocol codecs, connection controller, and
    config validator.
2026-08-04 docs: record Zephyr/Arduino parity gap and Z5 catch-up plan
    Arduino firmware advanced past the Z3/Z4 Zephyr acceptance point (PowerManager
    FSM, deep sleep adapter, BLE Companion Sync) without the Zephyr port following.
    Documents the verified gap and adds the implementation plan to close it.
2026-08-04 feat(zephyr): port PowerManager FSM from Arduino (Z5.1)
    Wires bike::PowerManager (already shared domain code) into the Zephyr
    AppController: config wiring, scheduler period throttling, BLE
    power-save advertising, and power-status/status serial commands,
    mirroring firmware/src/app_controller.cpp exactly. Consolidates the
    Zephyr app and ztest domain source lists into a single
    cmake/domain_sources.cmake so a module can't be added to one and
    silently missed by the other again.
    Adds BleManager::applyPowerSaveAdvertising()/stopAdvertising() (real
    and stub variants) and DisplayManager::displayTestActive(), plus a new
    ztest power_manager suite covering power-save mode timeout, deep-sleep
    timeout-ze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
    [app_controller.cpp, app_controller.h, ble_manager.h, ble_manager_stub.cpp, ble_manager_zephyr.cpp, display_manager.h]
2026-08-04 feat(zephyr): port deep sleep adapter from Arduino (Z5.2)
    Ports the nrfx-register deep-sleep (System OFF) adapter from
    firmware/src/platform/deep_sleep_nrf52.cpp into Zephyr, wiring it into
    AppController::handlePowerManagerResult's request_enter_deep_sleep
    branch (the placeholder Task 1 left). Adds raw nRF52840 GPIO constants
    to board_pins.h, a CONFIG_BIKECOMP_DEEP_SLEEP Kconfig gate (default y,
    mirrors Arduino's BIKECOMP_FEATURE_DEEP_SLEEP), and flips
    g_deep_sleep_supported in the BLE Device Info characteristic to the
    compiled-in flag.
    Uses the raw nrf_power_system_off(NRF_POWER) HAL call (verified
    present in the vendored nrfx) instead of SoftDevice's
    sd_power_system_off(), since Zephyr's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
    [app_controller.cpp, app_controller.h, ble_manager_zephyr.cpp, board_pins.h, deep_sleep.h, deep_sleep_zephyr.cpp]
2026-08-04 feat(zephyr): port BLE Companion Sync clock/weather from Arduino (Z5.3)
2026-08-04 fix: restore CI green and Zephyr display power parity
    Bootstrap Zephyr CI via west update (deps/zephyr v4.4), regenerate simulator
    goldens after companion layout shift, format mobile-app sources, and drop the
    Zephyr-only BLE noteActivity that blocked display dim/off timeouts.
    [app_controller.cpp]
2026-08-05 fix(zephyr): fetch u8g2 in west workspace for CI builds
    Add olikraus/u8g2 to west.yml, auto-detect deps/u8g2 in CMake/build.sh, and
    install device-tree-compiler in the Zephyr CI job so west build no longer fails
    with a missing U8G2_ROOT.
2026-08-05 chore: harden release workflow and prepare v0.2.0-beta.2
    Add Zephyr build artifacts, per-tag changelog notes, workflow_dispatch tag
    input, and mobile format gate to the Release workflow; bump mobile build +4
    and document the release cut procedure in README.
2026-08-05 chore: drop unrelated files accidentally staged in iOS removal commit
2026-08-05 fix: restore hall ISR timing and unblock live speed calculation
    Speed stayed at zero while distance and average kept updating because
    polling lost pulse intervals and the gap guard stretched post-pause
    cadence back to stale long gaps. Restore digital Hall ISRs, tighten
    interval validation, and reset the guard when movement resumes.
    [app_controller.cpp, test_main.cpp, wheel_sensor.cpp, wheel_sensor.h]
2026-08-05 fix(zephyr): port hall ISR speed fix from ccdd4d3 to app layer
    Apply interval guard reset on ride resume, use interval_us for speed
    updates, and gate live speed on hasPulse. Mirror domain regression tests
    in ztest (29 cases).
    [app_controller.cpp]
2026-08-06 feat: add new 3D model for Velopulse
    [velopulse.3mf]
2026-08-06 docs: add ambient light auto-calibration design spec
    Design for passively learning raw_dark/raw_bright per-device and
    persisting it like the odometer, with a quality flag surfaced via
    debug log. Arduino-only for this iteration; Zephyr port is follow-up.
2026-08-07 docs: clarify calibration bootstrap and quality-flag limitation
    Confirmed with user: calibrator starts from existing compile-time
    defaults, not an empty range. Documents that this makes the quality
    flag an absorbing kOk state rather than a genuine first-calibration
    trust signal, so implementers rely on the logged raw bounds too.
2026-08-07 docs: ground calibration quality thresholds in real hardware defaults
    The header's 100/3900 fallback is never used on real builds --
    platformio.ini sets BIKECOMP_AMBIENT_RAW_DARK/BRIGHT to 266/1126 for
    every xiao_ble_sense variant. Retuned min-width/dark/bright thresholds
    so the actual factory pair still classifies as kOk.
2026-08-07 docs: add ambient light auto-calibration implementation plan
    8 tasks: shared rail-margin constant, AmbientLightCalibrator domain
    class, StorageManager ambient calibration payload type,
    AmbientCalibrationSavePolicy, AmbientLightManager wiring, then
    AppController boot-seed + persist-trigger wiring, plus full-suite
    verification.
2026-08-07 refactor: share ambient light invalid-rail margin constant
2026-08-07 feat: add ambient calibration payload type to StorageManager
2026-08-07 test: cover full trigger priority chain in AmbientCalibrationSavePolicy tests
    - Extend the one-shot/usb-disconnect test to assert deep sleep beats a
    pending usb disconnect, and usb disconnect beats a throttled change,
    closing the last gap in the reboot > deep sleep > usb disconnect >
    throttled change priority chain.
    - Add a test for noteUsbPresent(false) as the very first call, verifying
    it only seeds the absent baseline instead of firing a spurious
    disconnect trigger.
    - Guard acknowledge() against being invoked with kNone so it can't
    update last_saved_ms_/has_saved_ as a side effect of a no-op trigger.
    [test_main.cpp]
2026-08-07 feat: wire AmbientLightCalibrator into AmbientLightManager
2026-08-07 feat: load and seed ambient light calibration at boot
2026-08-07 feat: persist ambient light calibration on change, deep sleep, reboot, USB disconnect
    [app_controller.cpp, app_controller.h]
2026-08-08 fix: escape snprintf percent in simulator and add weather golden frames
    CI Simulator failed because firmware_renderer.cpp used R40% in snprintf
    without escaping the trailing percent sign. Add golden PNG fixtures for
    the new weather_clock and weather_rain carousel scenarios.
2026-08-08 feat: port Arduino speed-gap harden and device reboot to dev
    Bring short-interval spike guard, serial/BLE reboot UX, and richer hall
    diagnostics from the Arduino path without Zephyr/USB-profile-only pieces.
    [app_controller.cpp, app_controller.h, hall_diagnose.py, test_main.cpp]
2026-08-08 feat: add PC web companion with settings UI, USB debug and redesigned shell
    BLE config draft with pull/sync-to-device, redesigned navigation shell,
    Seeed XIAO Web Serial fixes (no DTR, CDC reconnect), and LDR debug panel.
2026-08-10 docs: sync status/backlog with dev branch state
    STATUS.md and TODO.md were dated 2026-08-01 and predated weather pages, the
    PC web companion, speed-gap guard/reboot, and ambient light auto-calibration.
    Reconcile checkboxes, test/golden-frame counts (116/116 native, 22 goldens),
    and build sizes against the current code, and add file:line detail to the
    remaining open software debts (watchdog, Scheduler timing, BLE indicator,
    production-loop blocking, RAM-only storage counters).
2026-08-10 fix(firmware): make Scheduler::nextDueMs wrap-safe, add task timing
    nextDueMs picked the task with the smallest raw next_due_ms instead of
    the smallest wrap-safe delta, so across a millis() rollover it could
    report a task due in ~2^31ms as "next" while a task actually due in
    single-digit ms waited. Compare deltas the same way isDue() already does.
    Also add optional per-task duration measurement to Scheduler (injected
    MicrosFn, since lib/domain has no Arduino dependency): last/max duration
    and budget-based overrun counting. Existing 2-arg call sites are
    unaffected; run_count/duration fields default to zero without a clock.
    [test_main.cpp]
2026-08-10 feat(firmware): surface Scheduler task timing via new "sched" command
    Wire micros() into the Scheduler constructed by AppController and give
    each task a named, documented overrun budget (flash-write-aware: state/
    ambient/display/battery can each trigger one InternalFsBackend write,
    ble can chain up to three on a dangerous-command factory reset). Add
    printSchedulerStats() and the "sched" Serial command to read
    run_count/last_us/max_us/overruns per task — this data previously
    existed nowhere (Э2.1).
    [app_controller.cpp, app_controller.h, test_main.cpp]
2026-08-10 feat(firmware): add nRF52 WDT reload-value domain calculation
    New watchdog_config.h converts a millisecond timeout to the nRF52 CRV
    register value (32.768kHz LFCLK), clamped to the documented >=0xF floor
    and the 32-bit register width. The multiply runs in uint64_t so
    timeouts beyond ~131s don't silently wrap in a uint32 intermediate.
    Pure domain code, no platform dependency yet — the nrf_wdt.h HAL shim
    that consumes this lands next.
2026-08-10 feat(firmware): add nRF52 watchdog platform shim
    src/platform/watchdog.{h} + watchdog_nrf52.cpp, mirroring the existing
    deep_sleep.h/deep_sleep_nrf52.cpp split so lib/domain stays Arduino-free.
    Uses the nrf_wdt.h HAL directly (the nrfx_wdt driver source isn't
    shipped in this core, so nrfx_wdt_* wouldn't link). RUN_SLEEP behaviour:
    keeps counting through low-power idle's delay() calls, pauses under a
    debugger halt. Not wired into AppController yet — that's next.
2026-08-10 feat(firmware): wire nRF52 watchdog into begin()/loop()/deep sleep
    Configure the WDT before any blocking init step (Serial wait, flash
    mount, SoftDevice enable), start it as the last step of begin() once
    those are done, and feed it unconditionally first thing in loop() so a
    wedge anywhere downstream still trips a reset. Also feed right before
    entering deep sleep, since a debugger-emulated System OFF leaves the
    WDT counting. New BIKECOMP_FEATURE_WATCHDOG flag (default on) disables
    it for debugging a suspected hang without the reset masking it.
    kSelftestWatchdogOk now sets on a successful start.
    fix(firmware): stop clobbering deep-sleep wake_source with cleared RESETREAS
    begin() read-and-cle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
    [app_controller.cpp, deep_sleep.h, deep_sleep_nrf52.cpp, test_main.cpp]
2026-08-10 feat(firmware): add wdt-hang Serial command for watchdog verification
    Deliberately spins loop() forever so the watchdog's actual reset
    behavior can be verified on hardware rather than assumed. Gated by
    BIKECOMP_FEATURE_WATCHDOG: with the feature off, it errors out instead
    of hanging the device with no way back.
    [app_controller.cpp, test_main.cpp]
2026-08-10 fix(tools): stop oled_gate_serial.py false-failing on the new watchdog bit
    The gate hard-compared selftest mask == 0x3F. A healthy device with the
    watchdog enabled now reports 0x7F (kSelftestWatchdogOk, bit 6), which
    would make every future gate run fail despite nothing being wrong.
    Check that the six pre-existing required bits are set instead of an
    exact match, so the gate stays valid for builds with the watchdog on or
    off (BIKECOMP_FEATURE_WATCHDOG).
    [oled_gate_serial.py]
2026-08-10 docs: close Э2.1 (scheduler timing) and watchdog in task backlog
    Record the watchdog + Scheduler task-timing work in STATUS.md/Готово
    and tasks/firmware/README.md, with the two adjacent bugs it fixed
    (wrap-unsafe nextDueMs, RESETREAS double-read). Update test/build
    numbers (127/127 native, fresh RAM/Flash for all three envs). Flag
    what's still open: hardware verification of wdt-hang on real XIAO,
    the per-task budgets being estimates pending real sched output, and
    that the underlying blocking calls in the production loop are now
    measurable but not yet removed.
2026-08-10 fix: restore Zephyr pairing and storage
    [ble_manager_zephyr.cpp, littlefs_backend.cpp]
2026-08-11 feat(firmware): wire live BLE connection state into OLED indicator (closes Э2.7)
2026-08-11 docs: remove stale Э2.7 BLE indicator debt line from STATUS.md next-steps
2026-08-11 docs: reconcile STATUS.md verification numbers and Zephyr caveat after Э2.7 close
2026-08-11 feat(firmware): add StorageCounters wire codec
2026-08-11 feat(firmware): persist StorageCounters in a new /cnt_a|b A/B slot
2026-08-11 feat(firmware): flush StorageCounters at deep-sleep and reboot checkpoints
    [app_controller.cpp, app_controller.h]
2026-08-11 fix(firmware): flush counters before deep-sleep power-off, reconcile docs after StorageCounters persistence
    [app_controller.cpp]
2026-08-11 fix(firmware): move BLE reboot counters flush after ambient-calibration save
    [app_controller.cpp]
2026-08-12 docs: remove stale watchdog/Э2.7 mentions from TODO.md next-steps (both already closed)
2026-08-12 feat(firmware): add clampIdleDelayMs helper for bounding blocking waits
2026-08-12 fix(firmware): bound low-power idle delay to 50ms chunks
    [app_controller.cpp]
2026-08-12 docs: correct idle-delay clamp framing — defensive bound, not an observed ~1000ms fix
2026-08-12 docs: cross-reference idle-delay clamp with scheduler periods, correct plan doc, widen test coverage
    [app_controller.cpp, test_main.cpp]
2026-08-13 fix(firmware): migrate test_embedded/test_smoke.cpp to the async StorageBackend interface
    [test_smoke.cpp]
2026-08-13 fix(firmware): stop stale odometer sequence tracking leaking into unrelated saves
    [test_main.cpp]
2026-08-13 fix(firmware): drain in-flight async saves before synchronous saveConfig/saveOdometer calls
    [app_controller.cpp]
2026-08-13 docs: close async flash writes debt in firmware backlog
    Update tasks/firmware/README.md and STATUS.md to reflect that flash
    writes are now async/chunked via the "storage" scheduler task, and
    sweep up four stale docs/comments left behind by Tasks 1, 3, and 4:
    the Zephyr-port caveat now lists the broken shared test double, the
    beginWrite() doc comment covers the over-length caller-error case,
    the test_smoke.cpp comment reflects InternalFsBackend's real two-poll
    split, and tryEnterDeepSleep's watchdogFeed() rationale comment is
    restored.
    [app_controller.cpp, test_smoke.cpp]
2026-08-13 fix(firmware): drain in-flight saves at FORCE_SAVE, deep-sleep-save checkpoint, and before reboot reset
    [app_controller.cpp, test_main.cpp]
2026-08-13 fix(firmware): migrate Zephyr LittleFsBackend to the async StorageBackend interface
    [littlefs_backend.cpp, littlefs_backend.h]
2026-08-16 feat(firmware): add Adafruit BLE DFU and ST-Link/BLE flash tooling
    Enable buttonless OTA when USB is dead, with make targets and docs for SWD first-flash and PC BLE updates.
2026-08-20 feat: add BLE CSC client for CYCPLUS C3 cadence and S3 speed
    BikeComp stays a companion peripheral and connects as central to one
    CSC sensor. C3 publishes cadence; S3 wheel revs drive trip/odometer
    while Hall is suppressed. Protocol 1.2 Telemetry v2 carries CSC status.
2026-08-20 test: fix S3 CSC fixture wheel event-time delta
    The first wheel packet already used event time 1024, so the second
    sample produced d_time=0 and no speed interval.
    [test_main.cpp]
2026-08-20 fix(firmware): reduce flash wear with stop-only odometer saves
    Drop distance and display-off triggers, save after 3 min paused settle,
    and skip counter checkpoint writes when only skipped_writes changed.
    [app_controller.cpp, test_main.cpp]
2026-08-21 feat(firmware): add BLE icons and dynamic cadence side panel
    Replace the BLE text label with phone and CSC icons, and show live cadence
    beside speed when valid while falling back to companion weather/clock otherwise.
    [test_main.cpp, types.h]
2026-08-21 ci: run jobs only for changed project areas
    Use path filters so docs-only and unrelated edits skip firmware, mobile,
    simulator, and Zephyr builds while shared domain changes still fan out.
2026-08-21 ci: skip build jobs when only workflow config changes
    Workflow edits no longer fan out to every project; use workflow_dispatch
    for a full manual CI run.
2026-08-21 ci: diff only the pushed commits for path filters
    Compare before..HEAD on push instead of the whole branch against main,
    so unrelated history on dev does not retrigger every job.
2026-08-23 feat: add companion display/CSC parity and stabilize phone MTU
    Companion apps now match firmware pages 0–7 and show CSC status. Phone
    links no longer drop on Samsung MTU exchange: the app settles and retries,
    and firmware pauses CSC scan while the phone is connected.
    [ble_manager.cpp, csc_central.cpp, csc_central.h]
